bahusvel/HAPi-Cluster/hardware/chassis/renders/Early Laser Blade.JPG

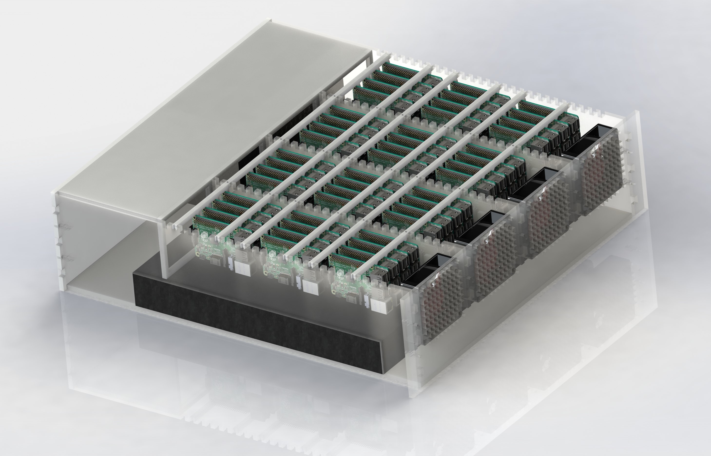
hardware/chassis/renders/Early Laser Blade.JPG
