bahusvel/HAPi-Cluster/hardware/chassis/renders/Later LaserBlade.JPG

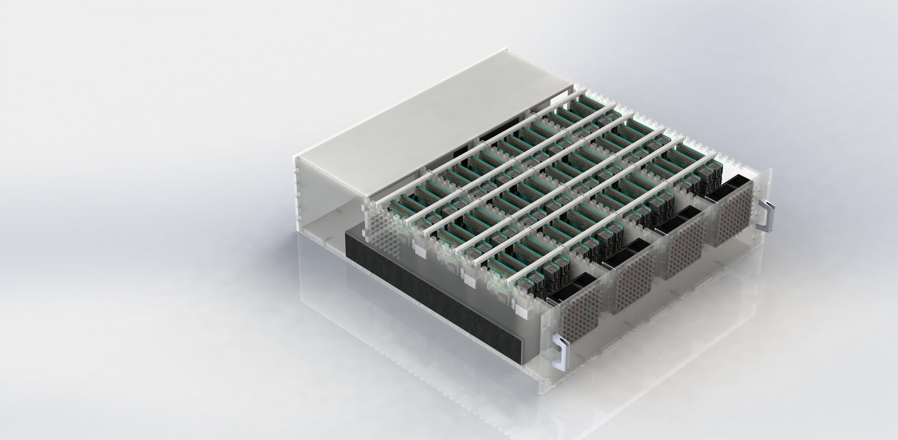
hardware/chassis/renders/Later LaserBlade.JPG
