bahusvel/HAPi-Cluster/README.md

# ClusterPipe
Flow processing scheduler daemon for real time parallel stream processing
