bahusvel/HAPi-Cluster/hardware/chassis/renders/In Rack Render.JPG

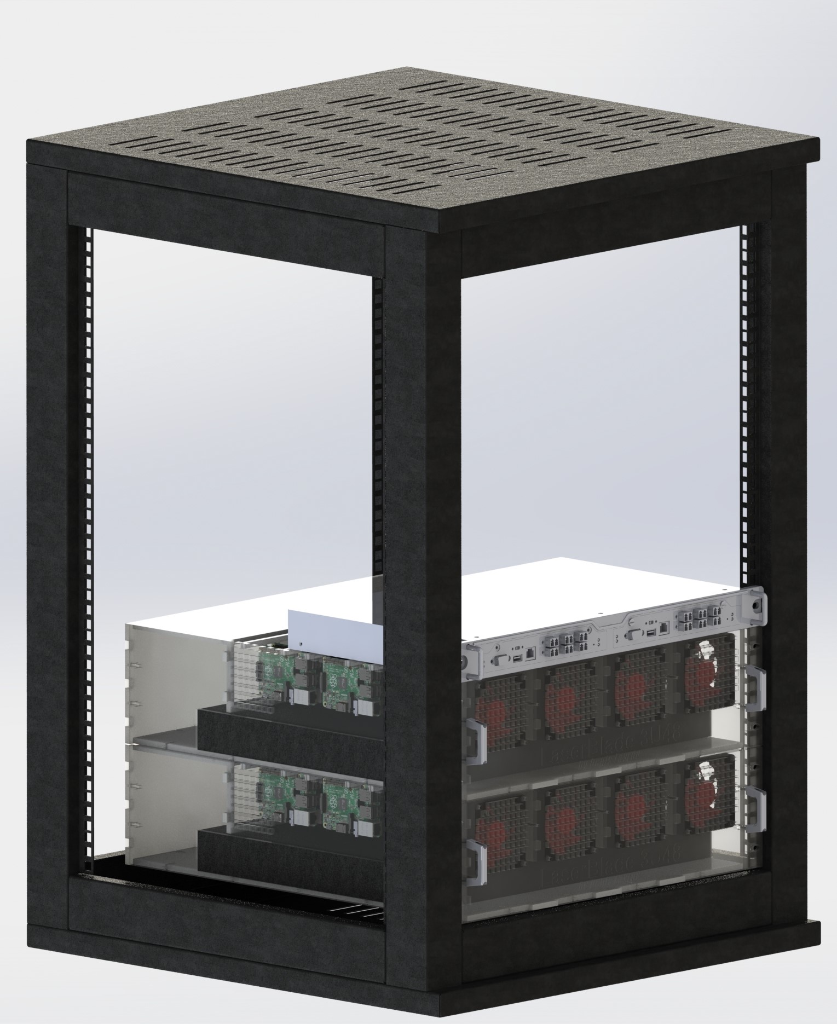
hardware/chassis/renders/In Rack Render.JPG
