bahusvel/HAPi-Cluster/hardware/chassis/sketch/Face.png

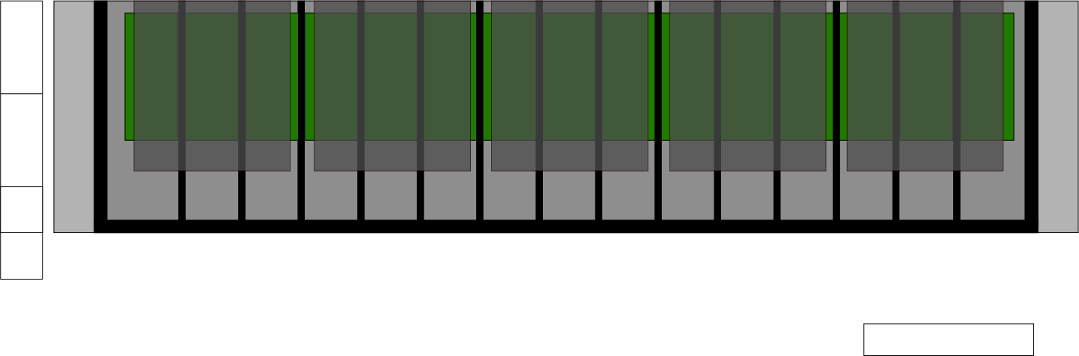
hardware/chassis/sketch/Face.png
