bahusvel/HAPi-Cluster/hardware/chassis/sketch/Top.png

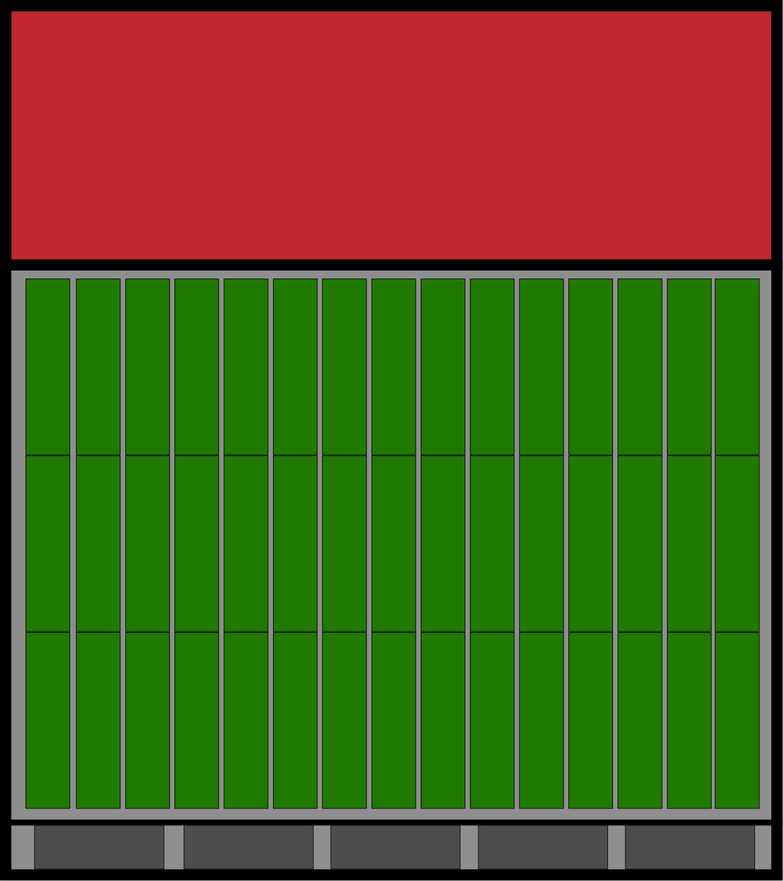
hardware/chassis/sketch/Top.png
