bahusvel/HAPi-Cluster/docs/Stage2.xlsx

Parts |  |  |  |  |  |  | USD->NZD:
Item | Link | Quantity | Cost USD | Cost NZD | Subtotal | Note | 1.39
N Channel Mosfet | http://nz.element14.com/fairchild-semiconductor/fdc6305n/mosfet-dual-nn-supersot-6/dp/9844805 | 60 |  | 0.779 | 46.74
Micro USB Vertical | http://nz.element14.com/global-connector-technology/usb3150-30-130-a/micro-usb-2-0-type-b-plug-th/dp/2537024 | 100 |  | 1.54 | 154
Acrylic 6mm | http://www.anythingacrylic.co.nz/flat-sheets/ | 6 |  | 50.78 | 304.68 | Cut to 900x600
Acryllic 4.5mm | http://www.anythingacrylic.co.nz/flat-sheets/ | 4 |  | 37.8 | 151.2 | Cut to 900x600
Local 10G SFP+ | https://www.pbtech.co.nz/product/NWXMLX1070/Mellanox-optical-module-ETH-10GbE-10Gbs-SFP-LC-LC | 4 |  | 205.85 | 823.4
LC/LC Multimode Patch | https://www.pbtech.co.nz/product/CABDNX7241/Dynamix-FL-LCLCOM4-1-1M-50u-LCLC-OM4-Fibre-Lead-Du | 4 |  | 21 | 84
M3 Fasteners | https://www.aliexpress.com/item/50pcs-Lot-Metric-M3-4-5-6-8-10-12-14-16-50mm-304-Stainless-Steel/32656651207.html | 4 | 3.6 | 5.004 | 20.016 | Choose 3x18
M3 Nuts | https://www.aliexpress.com/item/500PCS-M3-nut-M3-the-pillars-supporting-nut-nut-M3-screw/32618811604.html | 1 | 5.2 | 7.228 | 7.228
M4 Fasteners | https://www.aliexpress.com/item/50-pc-lot-M2-M2-5-M3-M4-L-4-50mm-DIN7991-Stainless-Steel-A2/32771971461.html | 2 | 5.7 | 7.923 | 15.846 | Choose M4 length 30mm
M4 Nuts | https://www.aliexpress.com/item/100pcs-M4-Nuts-A2-Stainless-Steel-Hex-Nuts-To-Fit-Our-Bolts-and-Screws/32668797352.html | 1 | 2.29 | 3.1831 | 3.1831
Multimode LC/LC Coupler | http://www.computerstore.co.nz/cables-connect/network-fibre-enclosures-cables-accessories/fibre-couplers/dynamix-fibre-lc-lc-quad-multi-mode-joiner | 2 |  | 10.66 | 21.32
Shift Registers | http://nz.element14.com/nxp/74hc595d/ic-74hc-cmos-smd-74hc595-soic16/dp/1201269 | 30 |  | 0.735 | 22.05
SMD LED | http://nz.element14.com/kingbright/kptr-3216seck/led-orange-1206-smd/dp/2099254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 | 100 |  | 0.241 | 24.1
SMT Resistor | http://nz.element14.com/vishay/crcw0402150rfkedhp/res-thick-film-150r-1-0-125w-0402/dp/1738839 | 100 |  | 0.033 | 3.3
PDU PCB | https://www.seeedstudio.com/fusion_pcb.html | 30 |  |  | 42.31 | Design provided by DENIS
Dell R230 3.5” Caddies | http://www.ebay.com/itm/3-5-SAS-SATA-Hard-Drive-Tray-Caddy-For-Dell-PowerEdge-Power-Edge-R230-R530-/361772477992 | 9 |  | 12.54 | 112.86 | Includes extra caddies for servers in the lab
Ribbon Cable | https://www.aliexpress.com/item/5m-lot-1-27mm-Pitch-20WAY-20P-Flat-Color-Rainbow-Ribbon-Cable-wire/1651786437.html | 2 | 6.99 | 9.7161 | 19.4322
12AWG Wire | https://www.jaycar.co.nz/1-0mm-enamel-copper-wire-spool/p/WW4022 | 2 |  | 13.9 | 27.8
C19 to AU power cord | https://www.pbtech.co.nz/product/CABPSU0107/Dynamix-C-PC15A-2M-Power-Cord---15-Amp-Rated-3-pin | 1 |  | 20.64 | 20.64
C13 to C14 cables | https://www.pbtech.co.nz/product/ITPCAP201/Dynamix-05M-SAA-Approved-Power-Cord-IEC-Male-to-Fe | 5 |  | 2.98 | 14.9
C14 to AU Socket | https://www.jaycar.com.au/iec-c14-male-to-3pin-mains-socket-150mm/p/PS4100 | 5 |  | 8.75 | 43.75
C14 Socket | http://nz.element14.com/multicomp/jr-101-1-frsg-02/inlet-iec-dpst-with-fuse-holder/dp/1516058 | 5 |  | 9.14 | 45.7
Microcontroller | https://www.aliexpress.com/item/Micro-ATmega32U4-5V-16MHz-Pins-soldered-Compatible-with-Arduino-Micro-and-Leonardo/32676998690.html | 3 | 4.8 | 6.672 | 20.016
12V Boost Converter | https://www.aliexpress.com/item/8W-USB-Input-DC-DC-5V-to-12V-Converter-Step-Up-Module-Power-Supply-Boost-Module/32756881160.html | 3 | 0.8 | 1.112 | 3.336
Crimping Tool | https://www.jaycar.com.au/5-way-crimping-tool/p/TH1828 | 1 |  | 8.95 | 8.95
Right Angle 40 Pin Female Header | https://www.aliexpress.com/item/Free-Shipping-one-lot-10pcs-2x20-Pin-2-54mm-Double-Row-Right-Angle-Female-Pin-Header/1680722686.html | 10 | 5.77 | 8.0203 | 80.203
Female 40 Pin Header | https://www.aliexpress.com/item/100pcs-lot-2-54mm-Double-Row-Female-12P-Straight-Header-Pitch-Socket-Strip-2X20-Pin/32454935478.html | 1 | 11.6 | 16.124 | 16.124
Parallella Desktop Board | http://www.digikey.co.nz/product-detail/en/adapteva-inc/P1600-DK02/1554-1000-ND/5018661 | 1 |  | 246.37 | 246.37
Parallella Server Board | http://www.digikey.co.nz/product-detail/en/adapteva-inc/P1601-DK02/1554-1001-ND/5018662 | 4 |  | 196.77 | 787.08
80mm Fan Filters | https://www.jaycar.com.au/80mm-plastic-fan-guard-filter-kit/p/YX2552 | 8 |  | 6.25 | 50
RJ45 Vertical Male PCB Connector | http://nz.element14.com/metz-connect/ajp92a8813/connector-rj45-plug-1port-8p8c/dp/2442534 | 100 |  | 2.53 | 253
Acrylic Cement | http://www.anythingacrylic.co.nz/anything-acrylic/accessories/acrylic-cement/ | 2 |  | 21 | 42 | Choose 5oz
Fork Crimps | https://www.aliexpress.com/item/1000Pcs-Electrical-Wire-Connector-Insulated-Crimp-Terminals-Kit-Spade-Assorted-Set-Fork-Ring-Assorted-Set-With/32751240130.html | 2 | 15.99 | 22.2261 | 44.4522
Heatshrink | https://www.aliexpress.com/item/280PCS-1-8-H-Assorted-Halogen-free-2-1-Polyolefin-Insulation-HeatShrink-Tubing-Tube-Kit-Shrinkable/32675699214.html | 2 | 6.11 | 8.4929 | 16.9858
 |  |  |  | Total: | 3473.5343
