bahusvel/HAPi-Cluster/hardware/chassis/components/rpi/raspberry_pi_B+_(HDMI_socket).SLDASM

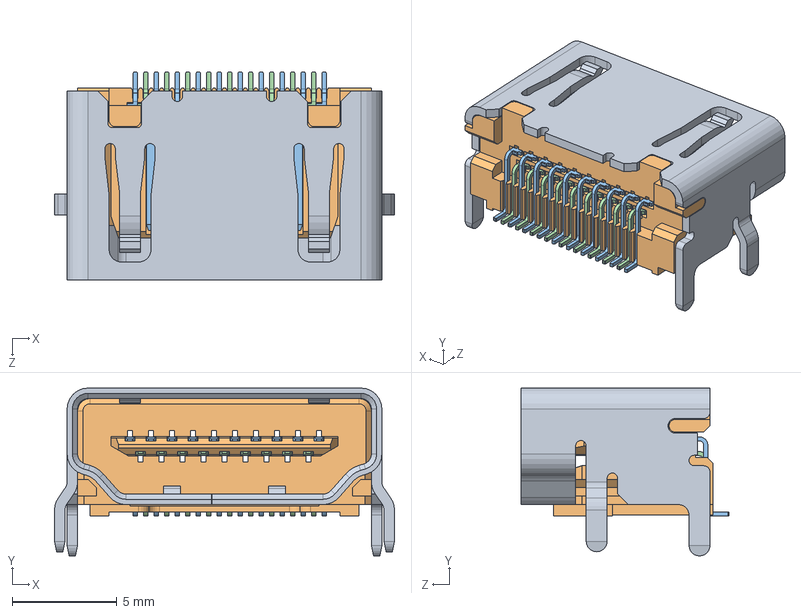
[picture p6: CAD file, 2017-01-25]
hardware/chassis/components/rpi/raspberry_pi_B+_(HDMI_socket).SLDASM
16.2 x 8.00 x 9.90 mm
raspberry_pi__HDMI_socket_cover
raspberry_pi__HDMI_socket_inside
raspberry_pi__HDMI_socket_large_pin x 10
raspberry_pi__HDMI_socket_small_pin x 9
