bahusvel/HAPi-Cluster/hardware/chassis/components/rpi/raspberry_pi_B+_(micro_USB).SLDASM

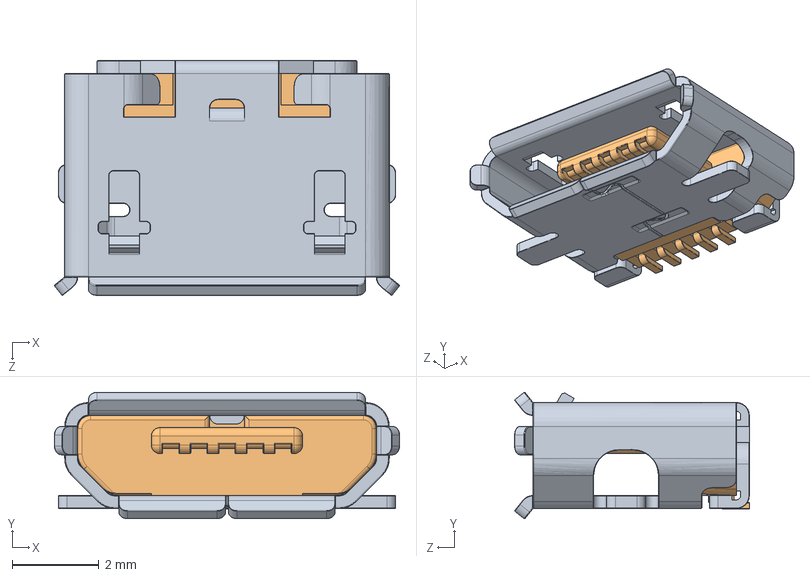
[picture p7: CAD file, 2017-01-25]
hardware/chassis/components/rpi/raspberry_pi_B+_(micro_USB).SLDASM
7.97 x 2.92 x 5.43 mm
raspberry_pi_B+_(micro_USB_cover)
raspberry_pi_B+_(micro_USB_contacts)
