bahusvel/HAPi-Cluster/hardware/chassis/components/server/User Library-fod-assy_asm.sldasm

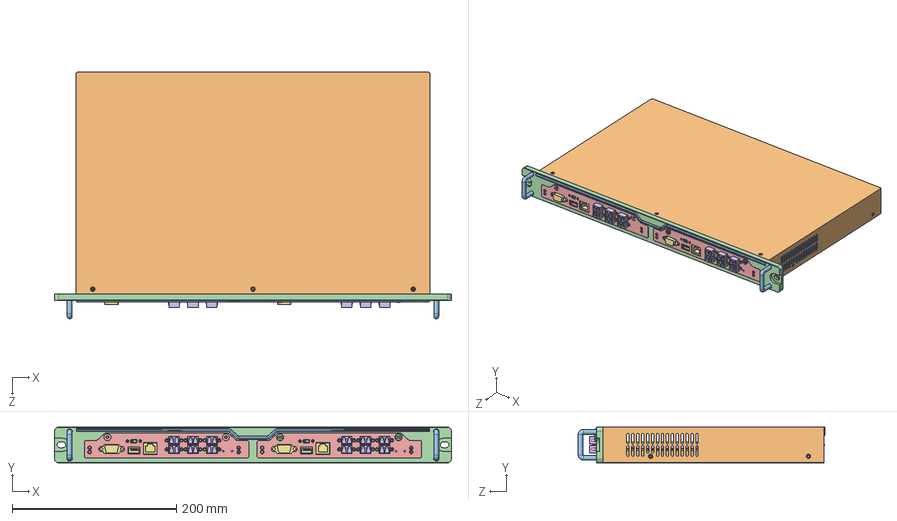
[picture p8: CAD file, 2017-02-03]
hardware/chassis/components/server/User Library-fod-assy_asm.sldasm
483.0 x 43.5 x 300.1 mm
User Library-fod-assy_asm_FOD-BASE
User Library-fod-assy_asm_FOD-TOP-COVER
User Library-fod-assy_asm_PRT0002 x 2
User Library-fod-assy_asm_FOD-FRONT-PANEL
User Library-fod-assy_asm_FOD-IO-PANEL x 2
User Library-fod-assy_asm_CONN-LC-TYPE-SCREW x 12
User Library-fod-assy_asm_FOD-MAIN-BD x 2
User Library-fod-assy_asm_SLIDE-SWITCH x 4
User Library-fod-assy_asm_FOD-BD-COVER x 2
User Library-fod-assy_asm_FOD-PCB-GUIDE x 4
User Library-fod-assy_asm_FOD-DESIGN-BAR
User Library-fod-assy_asm_FOD-CAP-SCREW x 2
User Library-fod-assy_asm_FOD-FRONT-BRKT
User Library-fod-assy_asm_FOD-SIDE-BRKT x 2
User Library-fod-assy_asm_FOD-BP-BD-ST
