bahusvel/HAPi-Cluster/hardware/chassis/rail_subasm.SLDASM

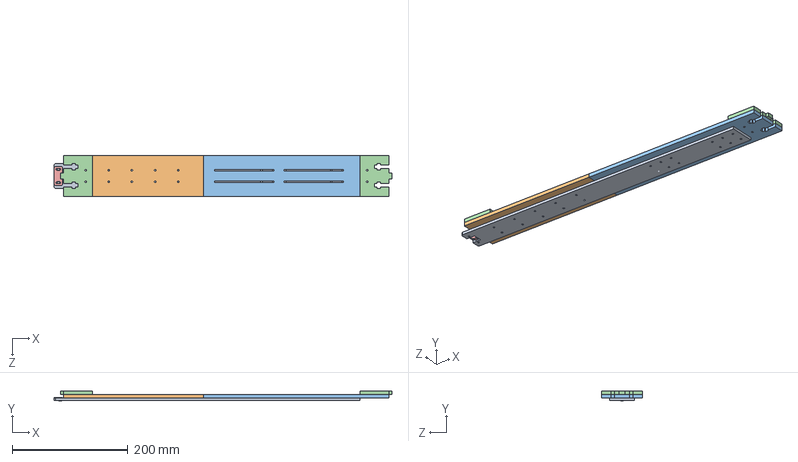
[picture p9: CAD file, 2017-02-11]
hardware/chassis/rail_subasm.SLDASM
583.5 x 17.5 x 70.0 mm
main_rail_4mm
rail_support_6mm
sliding_rail_6mm
railwidth_6mm x 2
rail_latch_3d
