bahusvel/HAPi-Cluster/hardware/chassis/lid_subasm.SLDASM

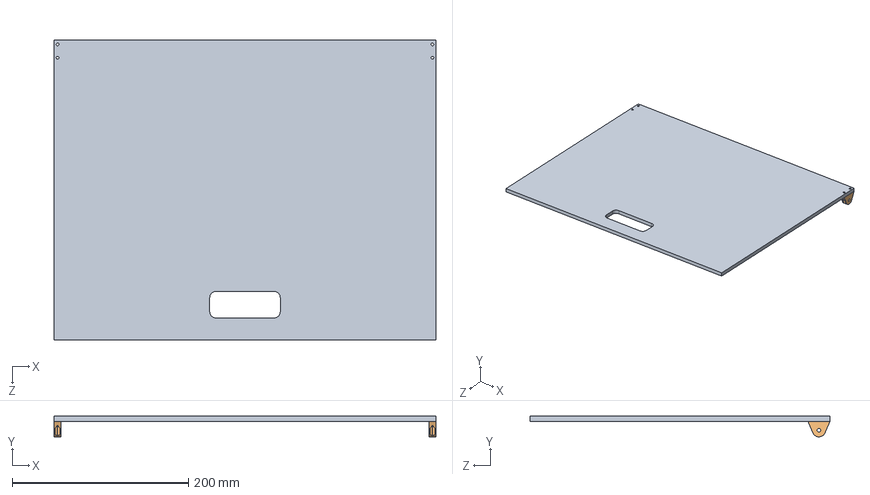
[picture p11: CAD file, 2017-02-11]
hardware/chassis/lid_subasm.SLDASM
433.0 x 23.5 x 340.0 mm
unit_lid_6mm
lid_hinge_3d x 2
