bahusvel/HAPi-Cluster/hardware/chassis/main_rail_4mm.SLDPRT

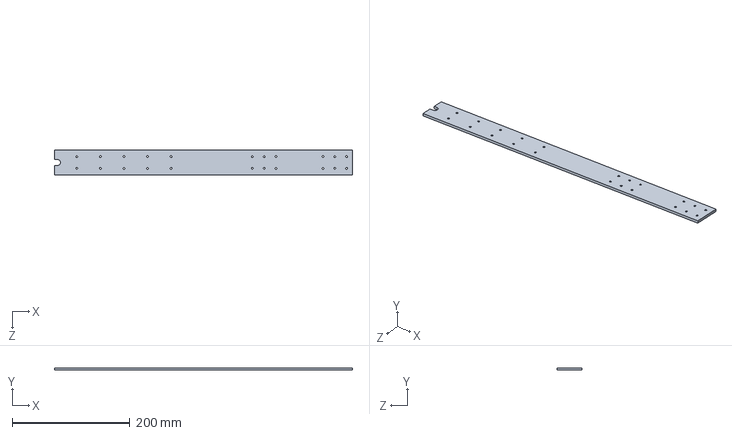
[picture p12: CAD file, 2017-02-11]
hardware/chassis/main_rail_4mm.SLDPRT
506.0 x 4.00 x 43.0 mm
