bahusvel/HAPi-Cluster/hardware/chassis/components/rpi/raspberry_pi_B+_(USB_x2).SLDASM

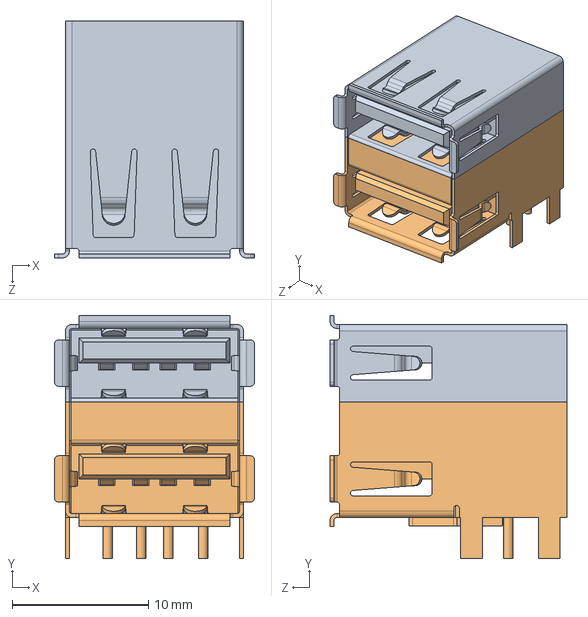
[picture p13: CAD file, 2017-01-25]
hardware/chassis/components/rpi/raspberry_pi_B+_(USB_x2).SLDASM
14.7 x 17.9 x 17.4 mm
raspberry_pi_B+_(USB_x2_part1)
raspberry_pi_B+_(USB_x2_part2)
