bahusvel/HAPi-Cluster/hardware/chassis/components/rpi/raspberry_pi_B+_(microsd).SLDASM

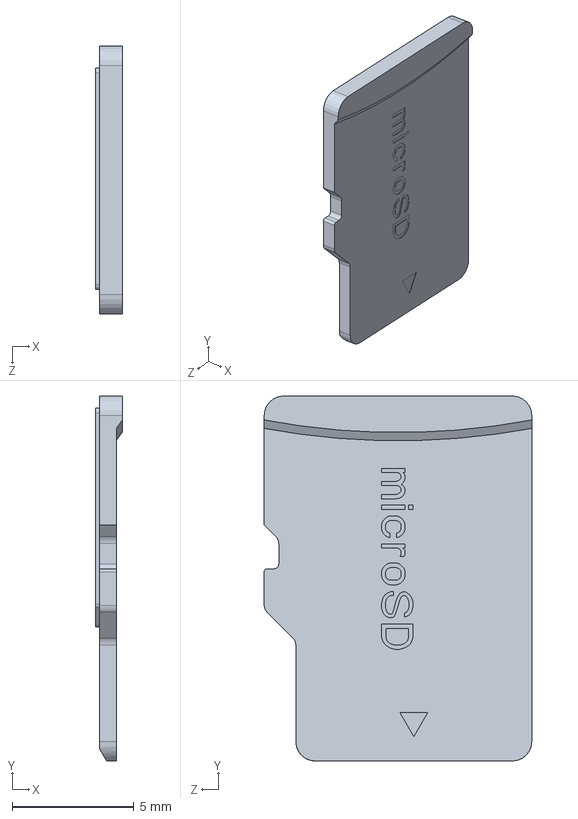
[picture p14: CAD file, 2017-01-17]
hardware/chassis/components/rpi/raspberry_pi_B+_(microsd).SLDASM
1.10 x 15.0 x 11.0 mm
