bahusvel/HAPi-Cluster/hardware/chassis/components/rpi/raspberry_pi_B+_(microsd_slot).SLDASM

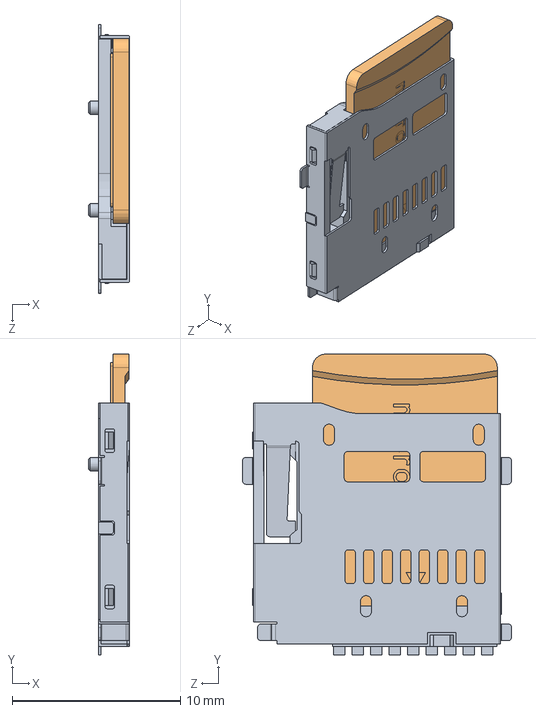
[picture p15: CAD file, 2017-01-17]
hardware/chassis/components/rpi/raspberry_pi_B+_(microsd_slot).SLDASM
2.44 x 17.9 x 16.0 mm
raspberry_pi_B+_(slot)
raspberry_pi_B+_(microsd)
