bahusvel/HAPi-Cluster/hardware/chassis/components/rpi/raspberry_pi_B+_(slot).SLDASM

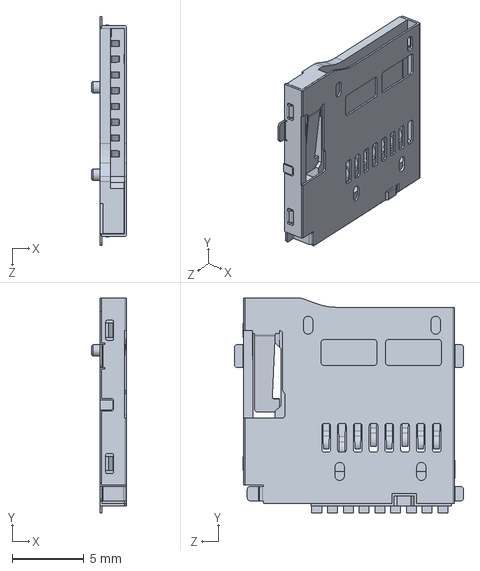
[picture p16: CAD file, 2017-01-17]
hardware/chassis/components/rpi/raspberry_pi_B+_(slot).SLDASM
2.44 x 15.0 x 16.0 mm
