bahusvel/HAPi-Cluster/hardware/chassis/components/power supply.SLDPRT

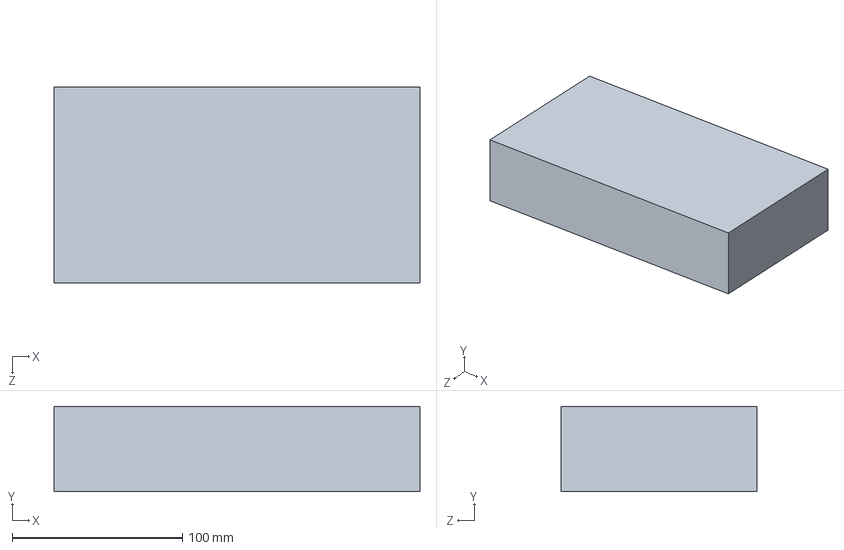
[picture p17: CAD file, 2017-02-11]
hardware/chassis/components/power supply.SLDPRT
215.0 x 50.0 x 115.0 mm
