bahusvel/HAPi-Cluster/hardware/chassis/components/rpi/raspberry_pi_B+_(audio_video2).SLDPRT

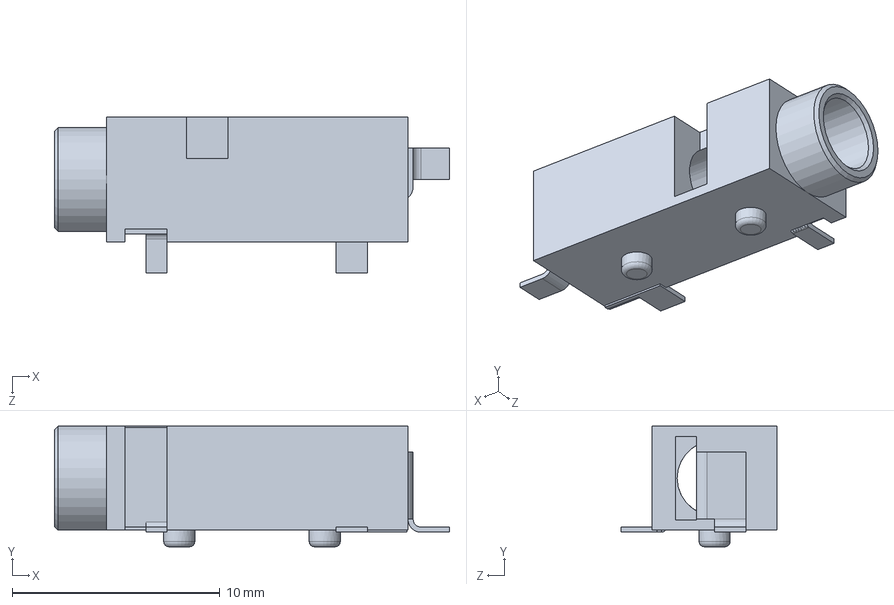
[picture p18: CAD file, 2017-01-25]
hardware/chassis/components/rpi/raspberry_pi_B+_(audio_video2).SLDPRT
19.0 x 5.80 x 7.50 mm
