bahusvel/HAPi-Cluster/hardware/chassis/components/shelf/TCH-506-9031900.SLDPRT

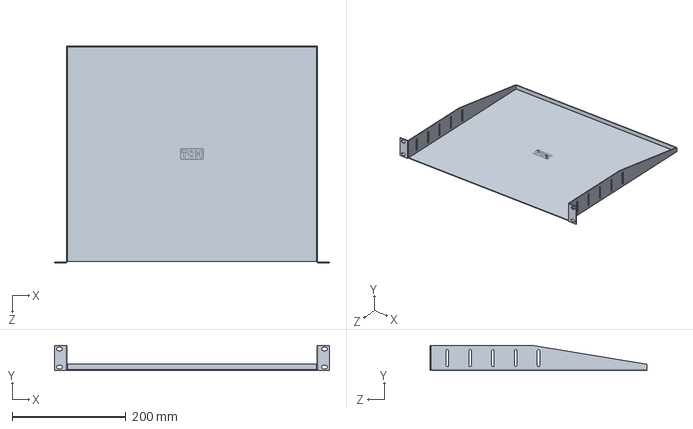
[picture p19: CAD file, 2017-02-03]
hardware/chassis/components/shelf/TCH-506-9031900.SLDPRT
482.6 x 44.1 x 380.0 mm
