bahusvel/HAPi-Cluster/hardware/chassis/bottom_plate_6mm.SLDPRT

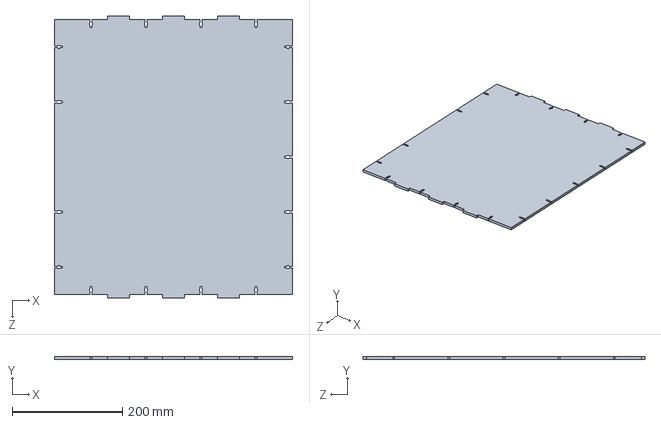
[picture p20: CAD file, 2017-03-06]
hardware/chassis/bottom_plate_6mm.SLDPRT
433.0 x 6.00 x 512.0 mm
