bahusvel/HAPi-Cluster/hardware/chassis/components/pdu_board.SLDPRT

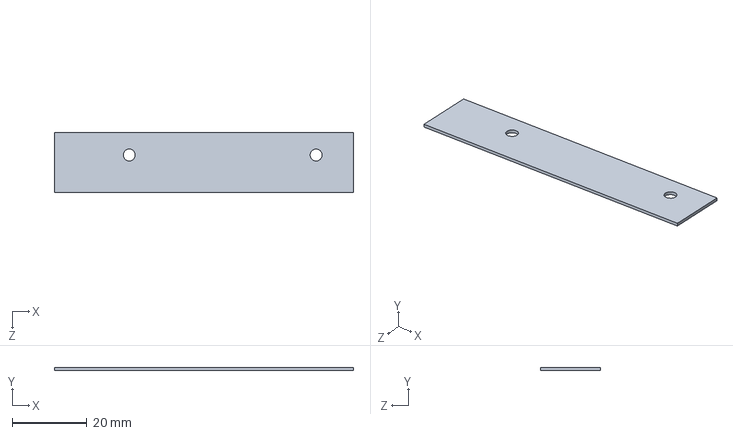
[picture p21: CAD file, 2017-01-30]
hardware/chassis/components/pdu_board.SLDPRT
80.0 x 0.8 x 16.0 mm
