bahusvel/HAPi-Cluster/hardware/chassis/components/fan/sunon_fan_red.stp

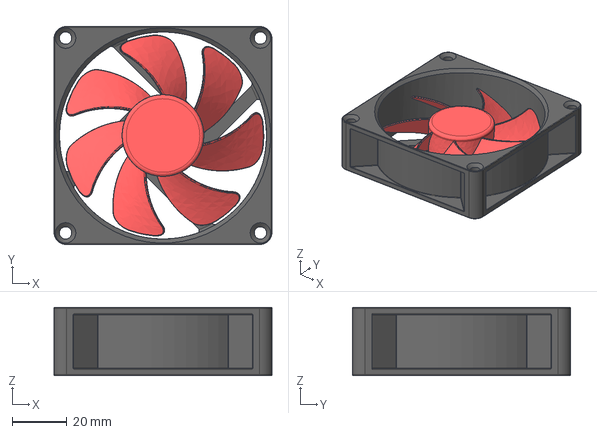
[picture p22: CAD file, 2017-01-17]
hardware/chassis/components/fan/sunon_fan_red.stp
80.0 x 80.0 x 25.0 mm
