bahusvel/HAPi-Cluster/hardware/chassis/components/rpi/raspberry_pi__HDMI_socket_inside.SLDPRT

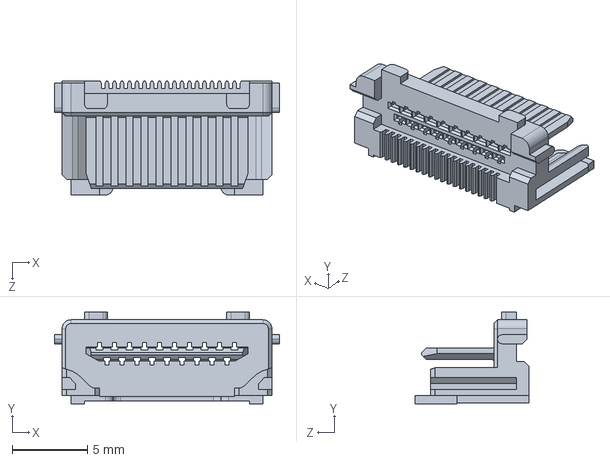
[picture p23: CAD file, 2017-01-25]
hardware/chassis/components/rpi/raspberry_pi__HDMI_socket_inside.SLDPRT
15.0 x 6.10 x 7.60 mm
