bahusvel/HAPi-Cluster/hardware/chassis/components/switch.SLDPRT

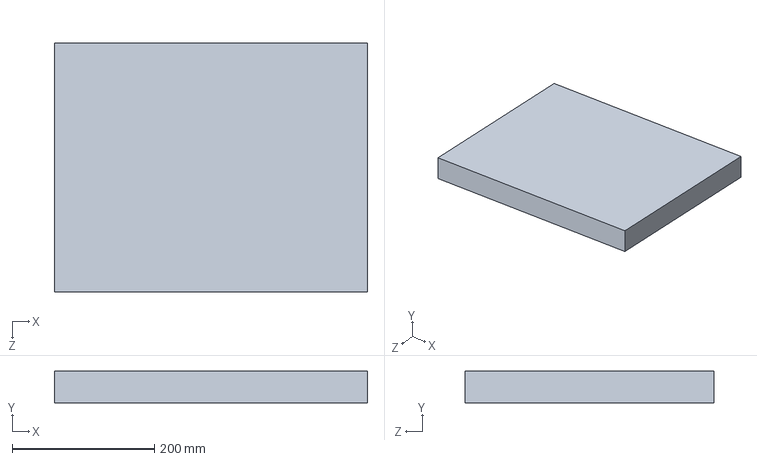
[picture p24: CAD file, 2017-01-25]
hardware/chassis/components/switch.SLDPRT
440.0 x 44.5 x 350.0 mm
