bahusvel/HAPi-Cluster/hardware/chassis/face_plate_6mm.SLDPRT

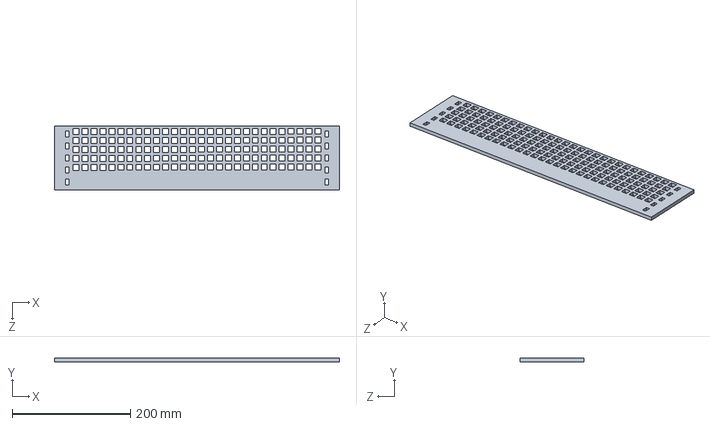
[picture p25: CAD file, 2017-03-06]
hardware/chassis/face_plate_6mm.SLDPRT
482.6 x 6.00 x 109.1 mm
