bahusvel/HAPi-Cluster/hardware/chassis/back_panel_6mm.SLDPRT

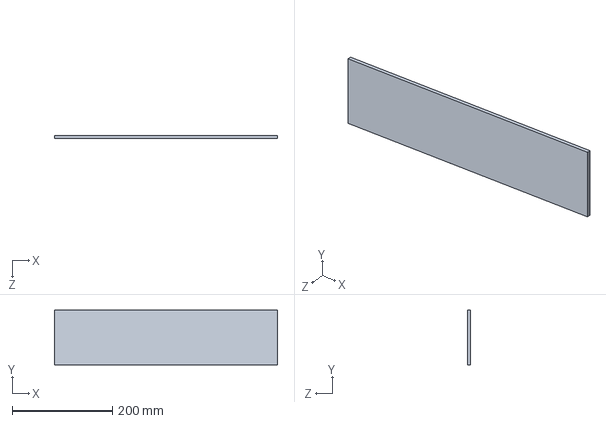
[picture p26: CAD file, 2017-03-06]
hardware/chassis/back_panel_6mm.SLDPRT
445.0 x 109.1 x 6.00 mm
