bahusvel/HAPi-Cluster/hardware/chassis/components/rack_backup/19inch Rack 16U.stp

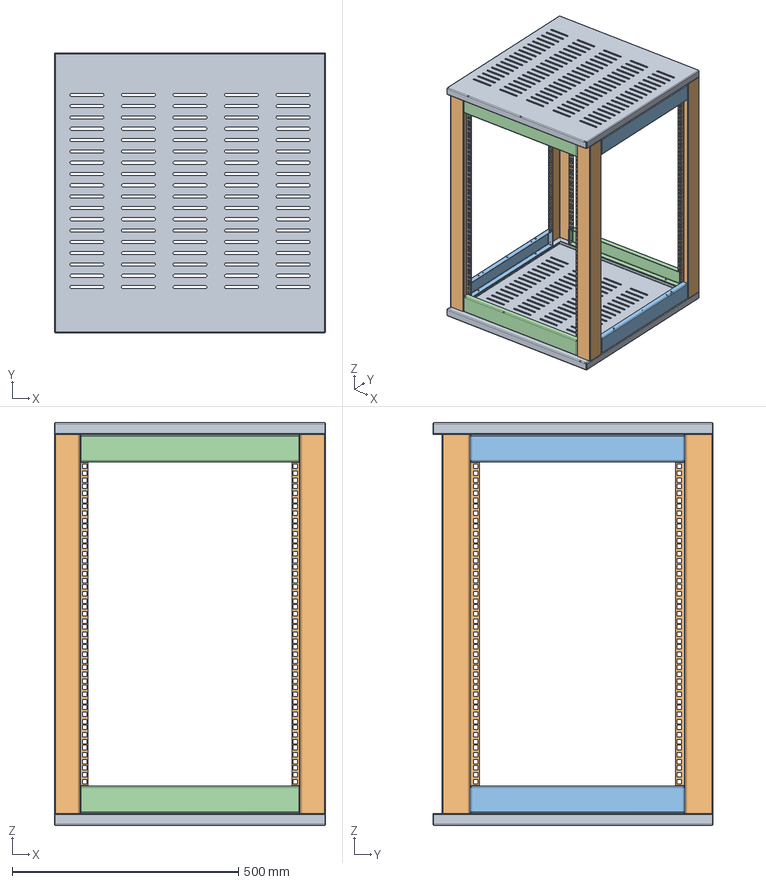
[picture p27: CAD file, 2017-01-17]
hardware/chassis/components/rack_backup/19inch Rack 16U.stp
600.0 x 620.0 x 891.0 mm
19inch Rack Top x 2
19inch Rack Corner Section x 16U x 4
19inch Rack In Fill section Side x 4
19inch Rack In Fill section Front-Rear x 4
