bahusvel/HAPi-Cluster/hardware/chassis/components/rpi/raspberry_pi_B+_(CI_Board).SLDPRT

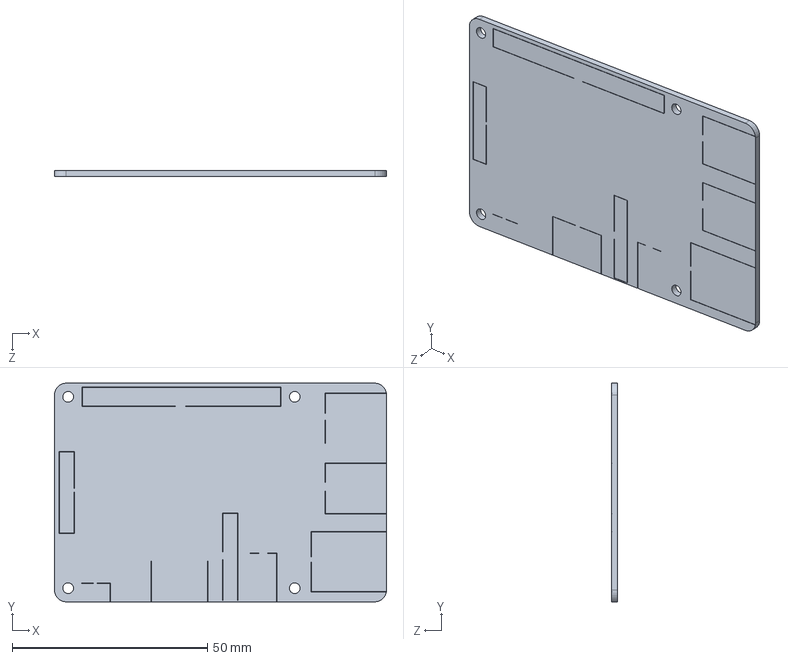
[picture p28: CAD file, 2017-01-25]
hardware/chassis/components/rpi/raspberry_pi_B+_(CI_Board).SLDPRT
85.0 x 56.0 x 1.60 mm
