bahusvel/HAPi-Cluster/hardware/chassis/components/rpi/raspberry_pi_B+_(microsd_slot2).SLDPRT

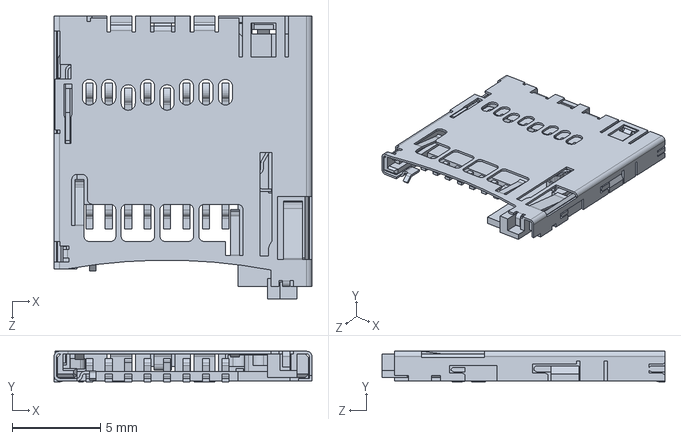
[picture p29: CAD file, 2017-01-25]
hardware/chassis/components/rpi/raspberry_pi_B+_(microsd_slot2).SLDPRT
14.6 x 1.73 x 16.0 mm
