bahusvel/HAPi-Cluster/hardware/chassis/power_separator_6mm.SLDPRT

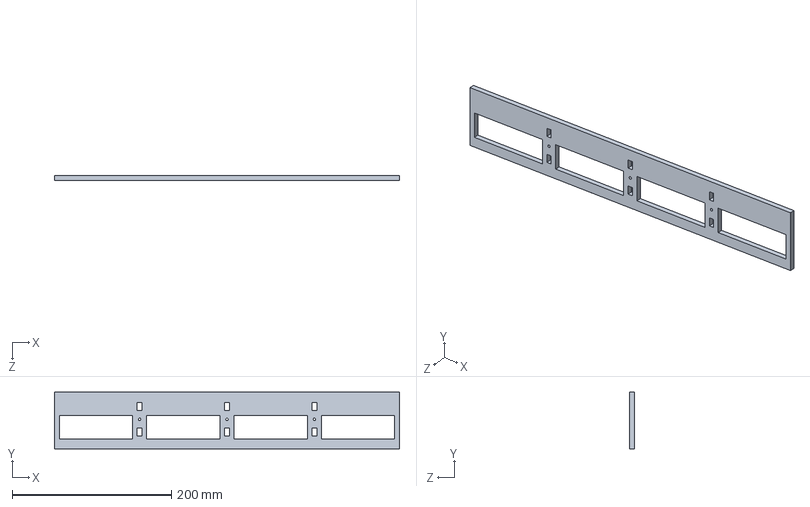
[picture p30: CAD file, 2017-03-06]
hardware/chassis/power_separator_6mm.SLDPRT
433.0 x 71.0 x 6.00 mm
