bahusvel/HAPi-Cluster/hardware/chassis/components/rpi/raspberry_pi_B+_(microsd2).SLDPRT

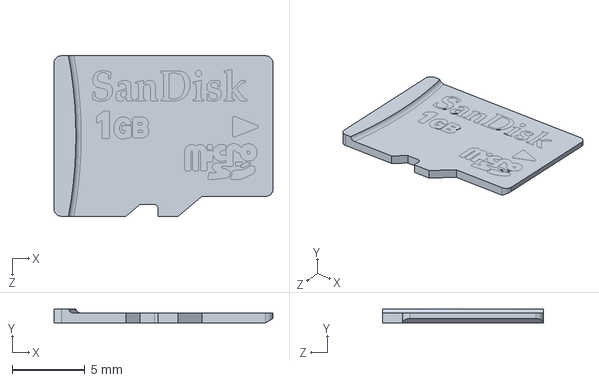
[picture p31: CAD file, 2017-01-25]
hardware/chassis/components/rpi/raspberry_pi_B+_(microsd2).SLDPRT
15.0 x 0.975 x 11.0 mm
