bahusvel/HAPi-Cluster/hardware/chassis/rib_6mm.SLDPRT

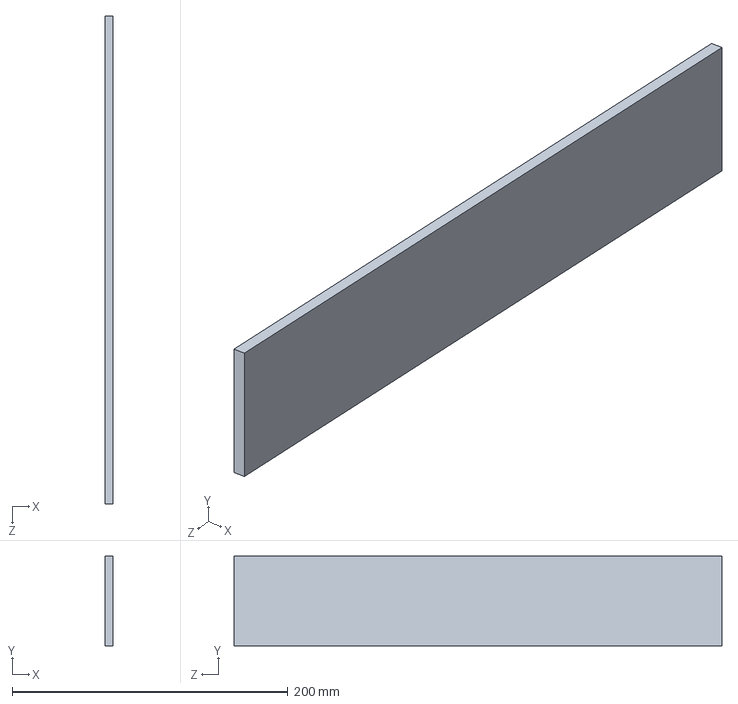
[picture p32: CAD file, 2017-02-11]
hardware/chassis/rib_6mm.SLDPRT
6.00 x 65.0 x 354.0 mm
