bahusvel/HAPi-Cluster/hardware/chassis/components/rpi/raspberry_pi_B+_(micro_USB_cover).SLDPRT

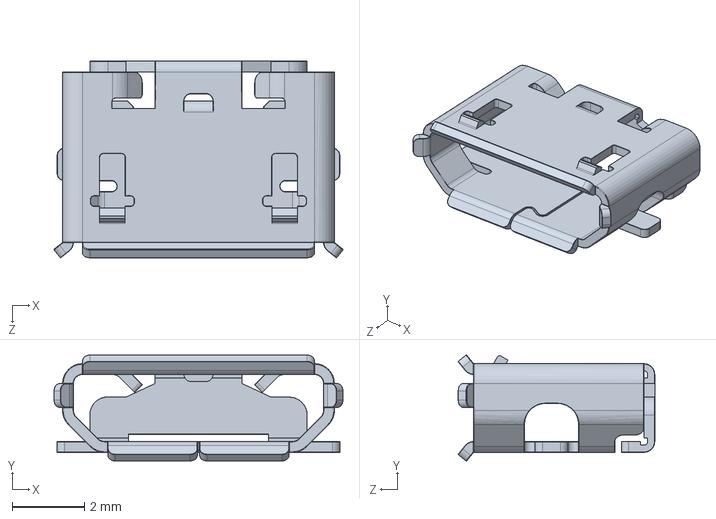
[picture p33: CAD file, 2017-01-25]
hardware/chassis/components/rpi/raspberry_pi_B+_(micro_USB_cover).SLDPRT
7.97 x 2.92 x 5.43 mm
