bahusvel/HAPi-Cluster/hardware/chassis/unit_lid_6mm.SLDPRT

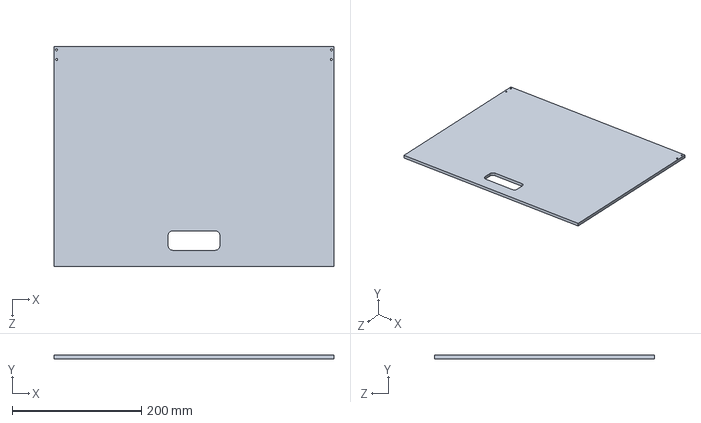
[picture p34: CAD file, 2017-02-11]
hardware/chassis/unit_lid_6mm.SLDPRT
433.0 x 6.00 x 340.0 mm
