bahusvel/HAPi-Cluster/hardware/chassis/power_lid_6mm.sldprt

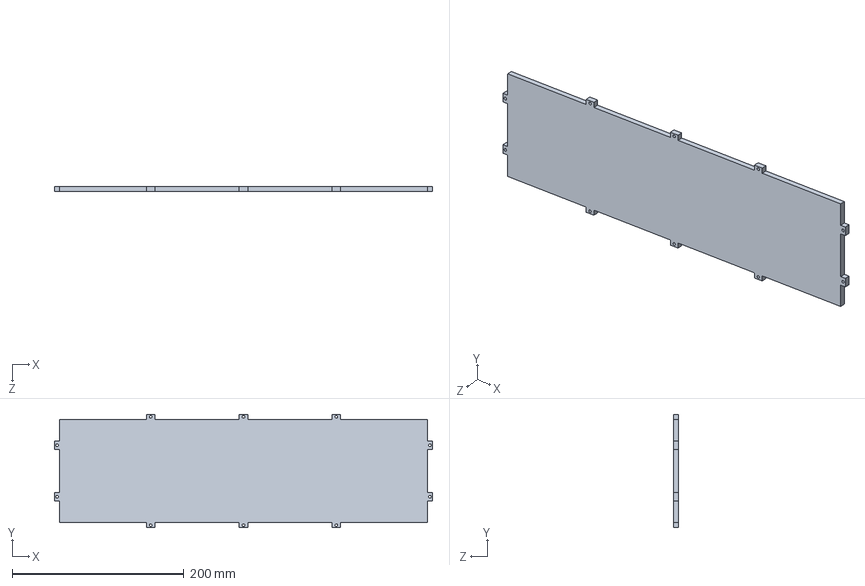
[picture p35: CAD file, 2017-02-11]
hardware/chassis/power_lid_6mm.sldprt
440.0 x 132.0 x 6.00 mm
