bahusvel/HAPi-Cluster/hardware/chassis/components/rpi/raspberry_pi__HDMI_socket_small_pin.SLDPRT

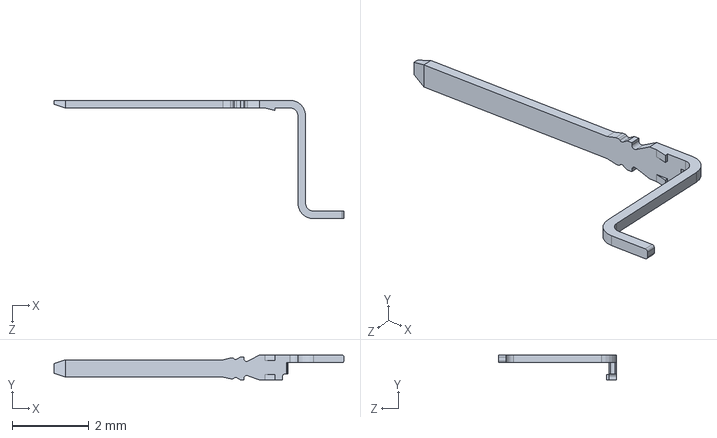
[picture p36: CAD file, 2017-01-25]
hardware/chassis/components/rpi/raspberry_pi__HDMI_socket_small_pin.SLDPRT
7.55 x 0.65 x 3.08 mm
