bahusvel/HAPi-Cluster/hardware/chassis/components/rpi/raspberry_pi_B+_(micro_USB_contacts).SLDPRT

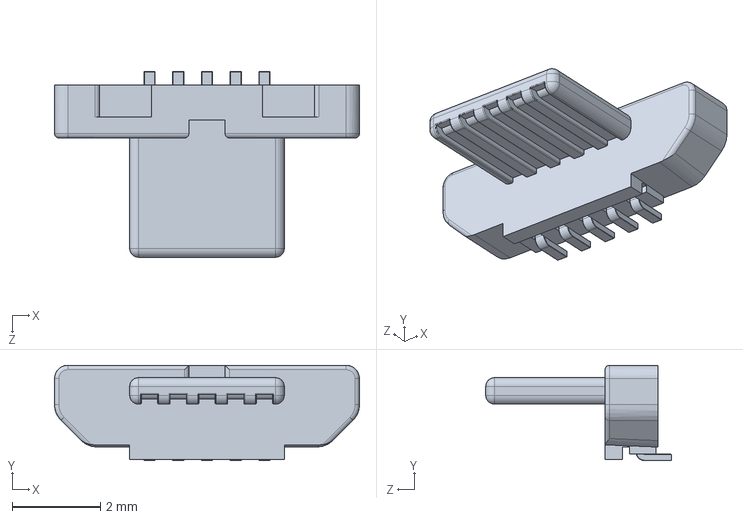
[picture p37: CAD file, 2017-01-25]
hardware/chassis/components/rpi/raspberry_pi_B+_(micro_USB_contacts).SLDPRT
6.90 x 2.16 x 4.20 mm
