bahusvel/HAPi-Cluster/hardware/chassis/side_plate_6mm.SLDPRT

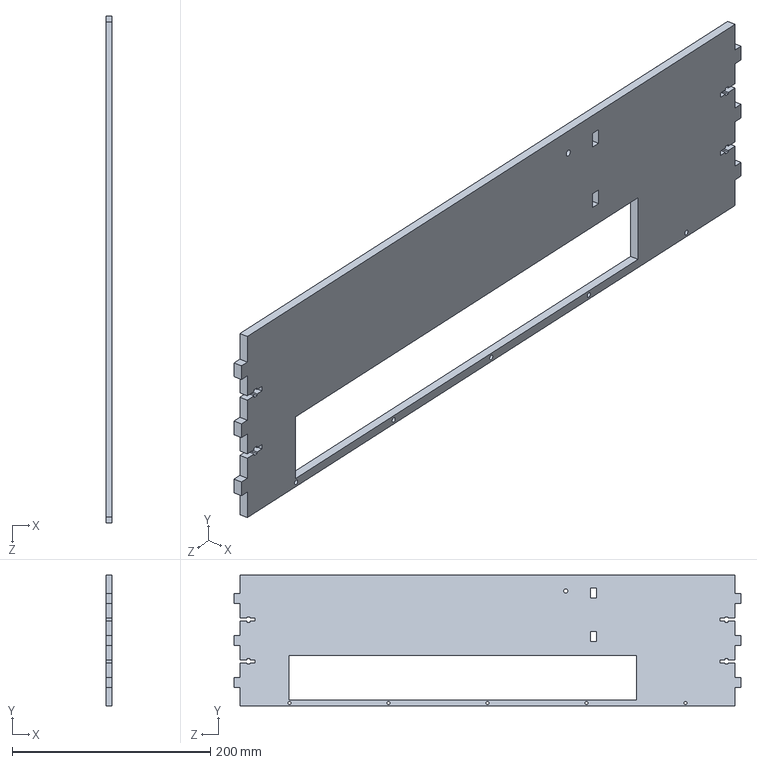
[picture p38: CAD file, 2017-02-11]
hardware/chassis/side_plate_6mm.SLDPRT
6.00 x 132.0 x 512.0 mm
