bahusvel/HAPi-Cluster/hardware/chassis/components/rpi/raspberry_pi_B+_(168_FBGA_12x12).SLDPRT

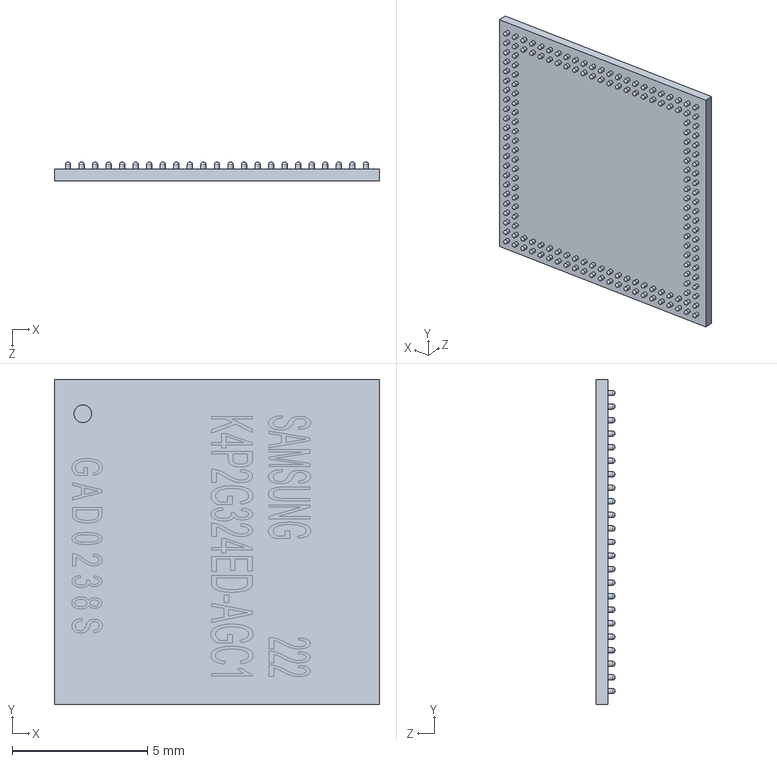
[picture p39: CAD file, 2017-01-25]
hardware/chassis/components/rpi/raspberry_pi_B+_(168_FBGA_12x12).SLDPRT
12.0 x 12.0 x 0.71 mm
