bahusvel/HAPi-Cluster/hardware/chassis/lower_rail_4mm.SLDPRT

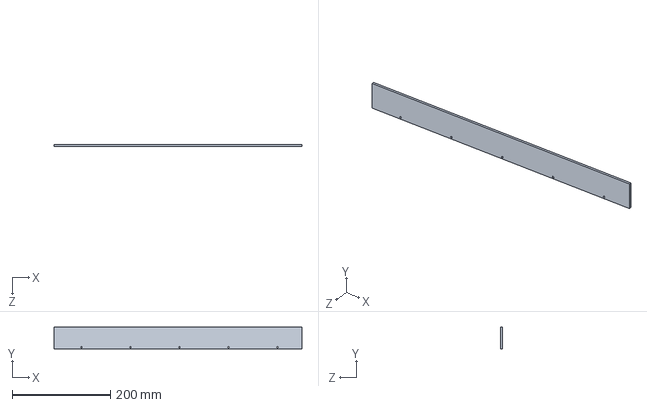
[picture p40: CAD file, 2017-02-11]
hardware/chassis/lower_rail_4mm.SLDPRT
506.0 x 44.0 x 4.00 mm
