bahusvel/HAPi-Cluster/hardware/chassis/components/rpi/raspberry_pi_B+_(USB_x2_part1).SLDPRT

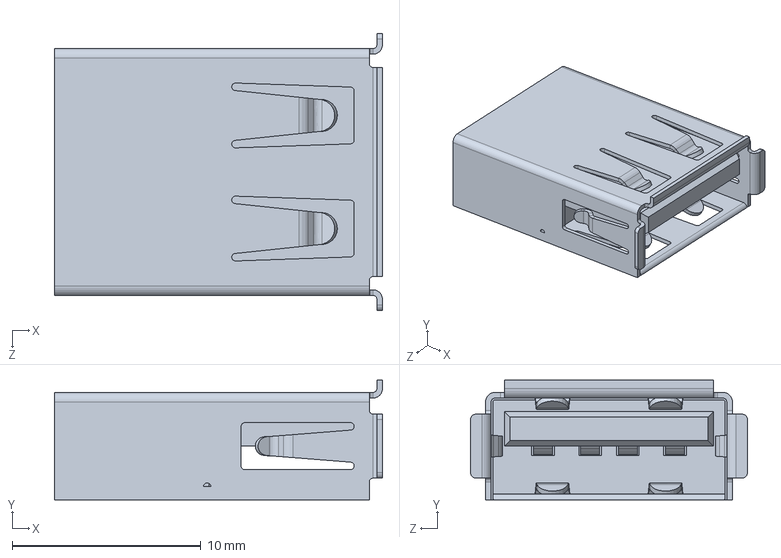
[picture p41: CAD file, 2017-01-25]
hardware/chassis/components/rpi/raspberry_pi_B+_(USB_x2_part1).SLDPRT
17.4 x 6.35 x 14.7 mm
