bahusvel/HAPi-Cluster/hardware/chassis/components/rpi/raspberry_pi__HDMI_socket_cover.SLDPRT

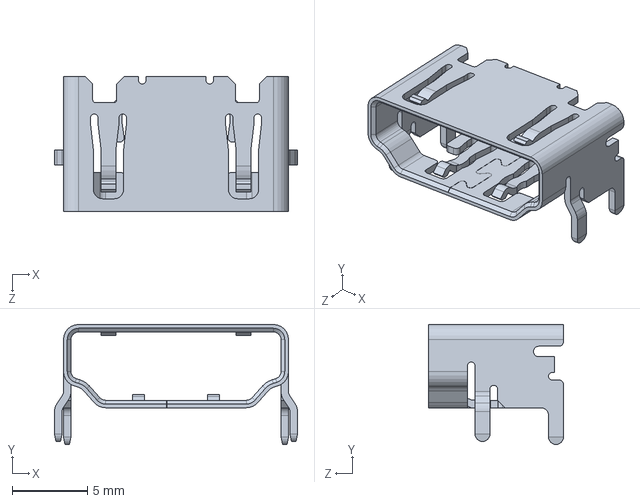
[picture p42: CAD file, 2017-01-25]
hardware/chassis/components/rpi/raspberry_pi__HDMI_socket_cover.SLDPRT
16.2 x 8.00 x 9.00 mm
