bahusvel/HAPi-Cluster/hardware/chassis/3u_handle_3D.SLDPRT

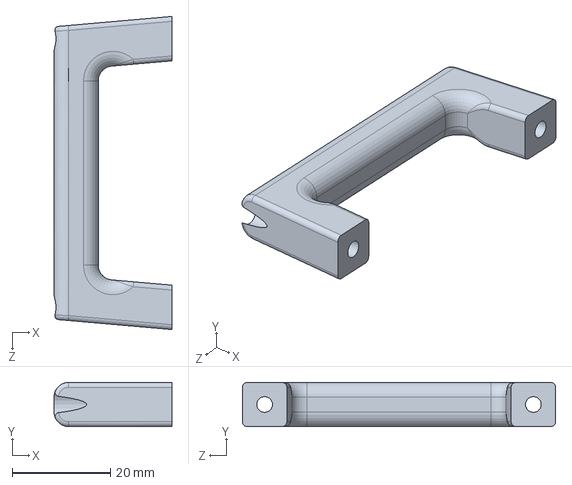
[picture p43: CAD file, 2017-02-11]
hardware/chassis/3u_handle_3D.SLDPRT
24.0 x 9.00 x 63.7 mm
