bahusvel/HAPi-Cluster/hardware/chassis/components/rpi/raspberry_pi__15_pin_FFC_Connector_locker.SLDPRT

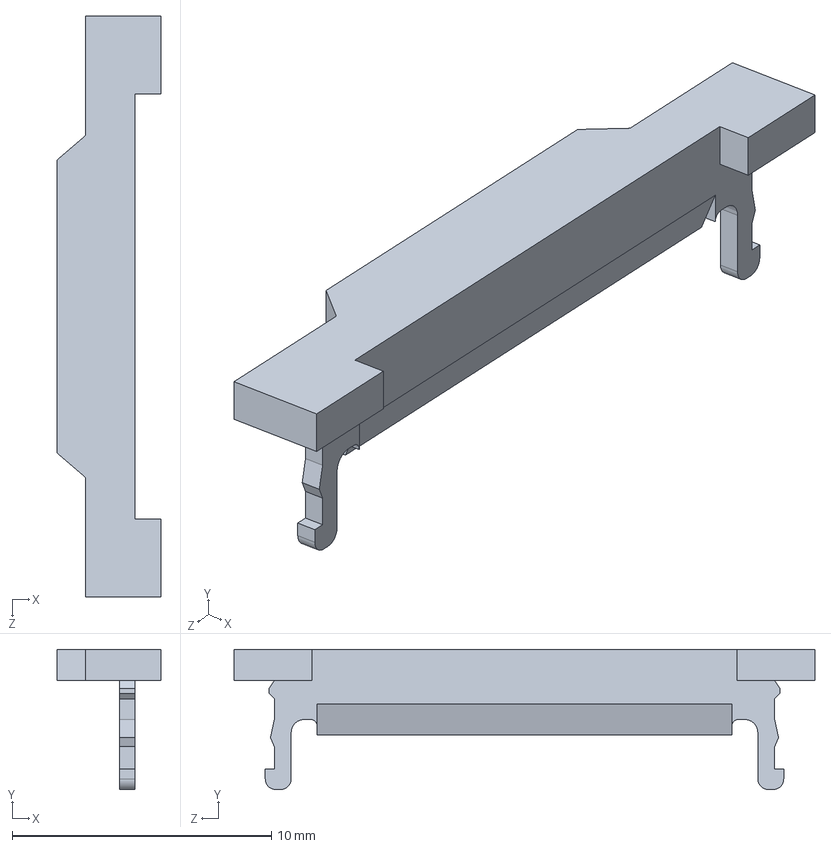
[picture p44: CAD file, 2017-01-25]
hardware/chassis/components/rpi/raspberry_pi__15_pin_FFC_Connector_locker.SLDPRT
4.00 x 5.40 x 22.4 mm
