bahusvel/HAPi-Cluster/hardware/chassis/components/rpi/raspberry_pi_B+_(USB_x2_part2).SLDPRT

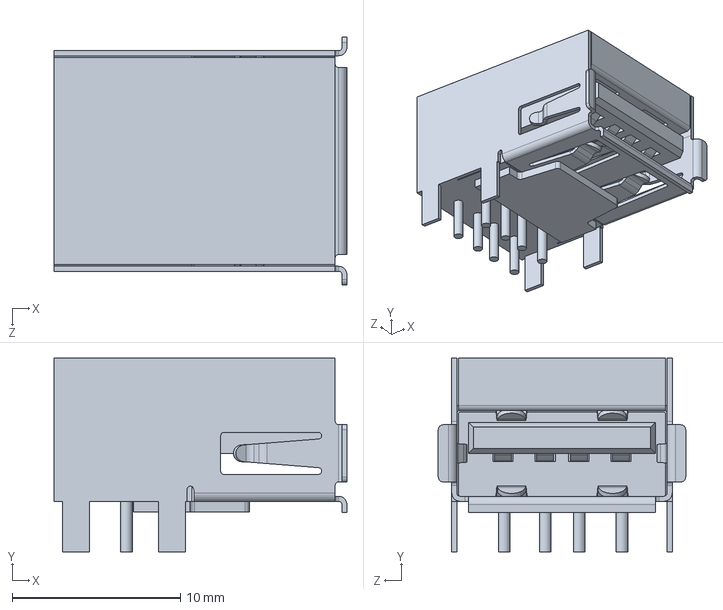
[picture p45: CAD file, 2017-01-25]
hardware/chassis/components/rpi/raspberry_pi_B+_(USB_x2_part2).SLDPRT
17.4 x 11.5 x 14.7 mm
