bahusvel/HAPi-Cluster/hardware/chassis/rail_endstop_3d.SLDPRT

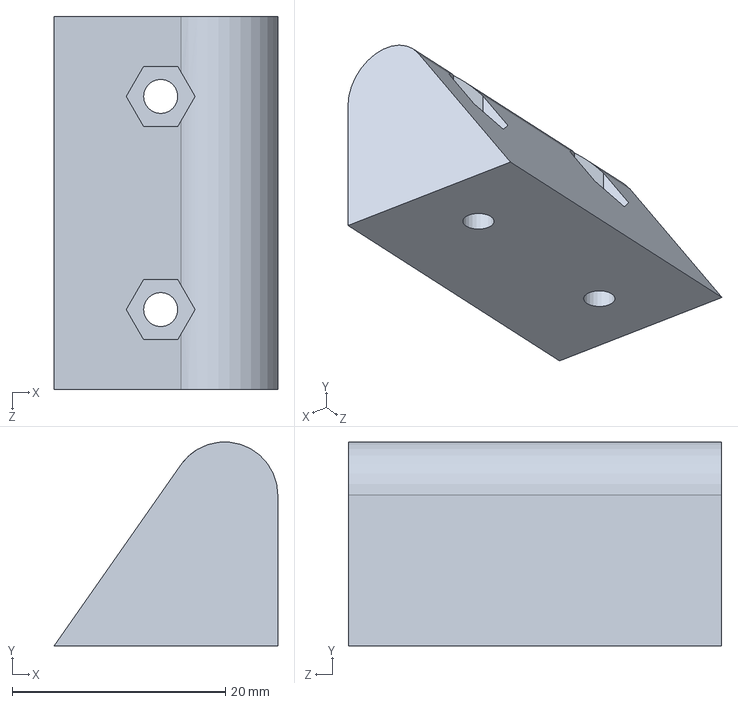
[picture p46: CAD file, 2017-02-10]
hardware/chassis/rail_endstop_3d.SLDPRT
21.0 x 19.1 x 35.0 mm
