bahusvel/HAPi-Cluster/hardware/chassis/components/rpi/raspberry_pi_B+_(QFN64).SLDPRT

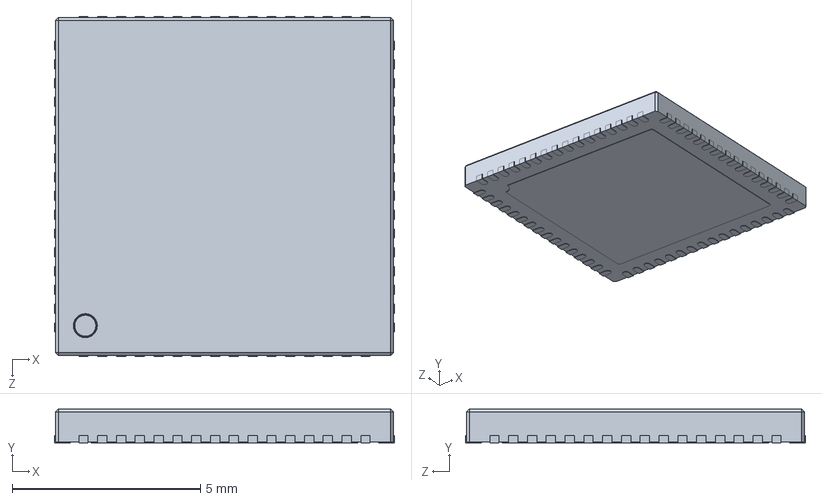
[picture p47: CAD file, 2017-01-25]
hardware/chassis/components/rpi/raspberry_pi_B+_(QFN64).SLDPRT
9.04 x 0.9 x 9.04 mm
