bahusvel/HAPi-Cluster/hardware/chassis/sliding_rail_6mm.SLDPRT

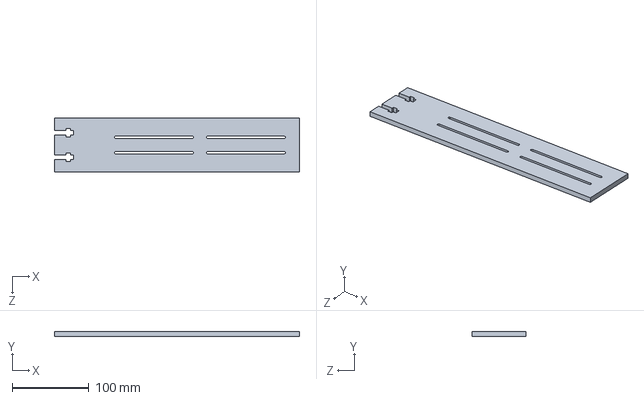
[picture p48: CAD file, 2017-02-10]
hardware/chassis/sliding_rail_6mm.SLDPRT
320.0 x 6.00 x 70.0 mm
