bahusvel/HAPi-Cluster/hardware/chassis/components/rpi/raspberry_pi__HDMI_socket_large_pin.SLDPRT

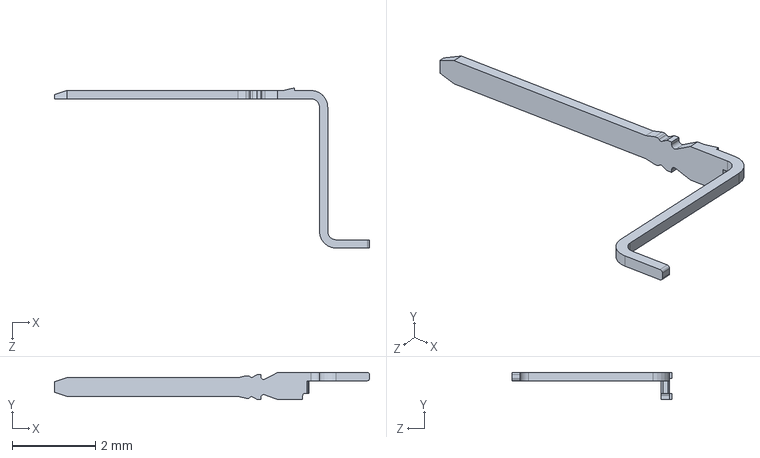
[picture p49: CAD file, 2017-01-25]
hardware/chassis/components/rpi/raspberry_pi__HDMI_socket_large_pin.SLDPRT
7.55 x 0.65 x 3.84 mm
