bahusvel/HAPi-Cluster/hardware/chassis/rail_support_6mm.SLDPRT

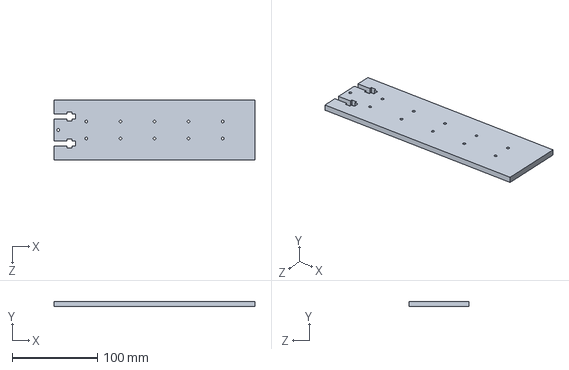
[picture p50: CAD file, 2017-02-10]
hardware/chassis/rail_support_6mm.SLDPRT
236.0 x 6.00 x 70.0 mm
