bahusvel/HAPi-Cluster/hardware/chassis/components/rpi/raspberry_pi__15_pin_FFC_Connector_body.SLDPRT

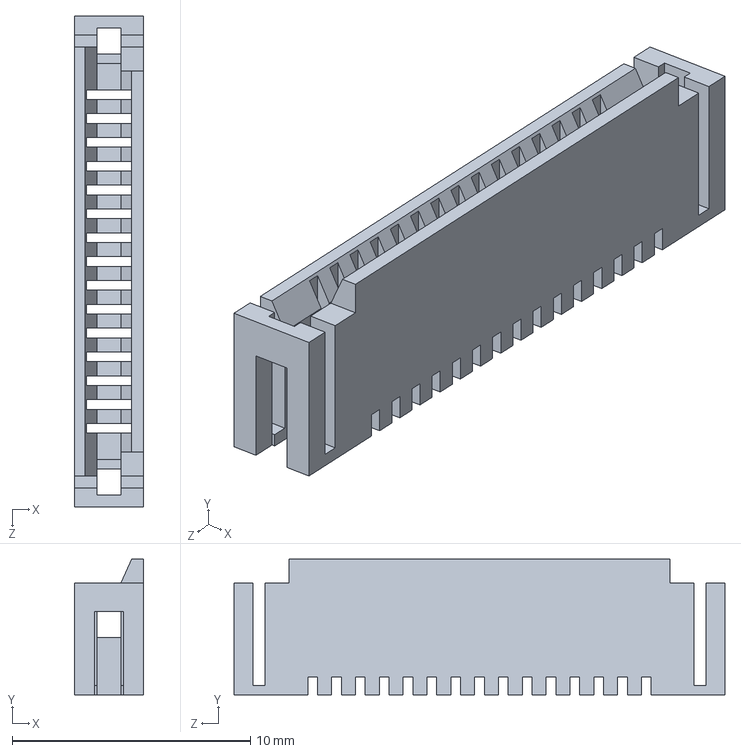
[picture p51: CAD file, 2017-01-25]
hardware/chassis/components/rpi/raspberry_pi__15_pin_FFC_Connector_body.SLDPRT
2.90 x 5.70 x 20.6 mm
