bahusvel/HAPi-Cluster/hardware/chassis/rail_latch_3d.SLDPRT

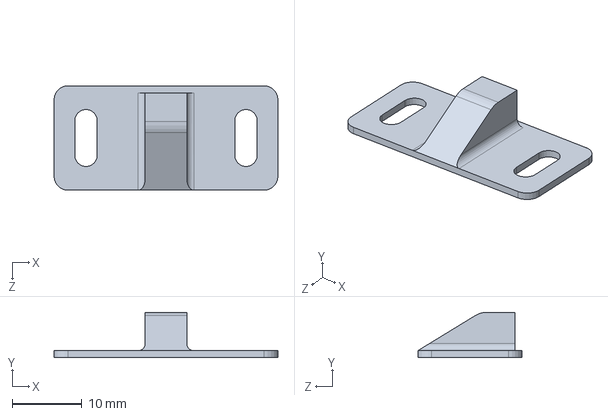
[picture p52: CAD file, 2017-02-10]
hardware/chassis/rail_latch_3d.SLDPRT
32.2 x 6.50 x 15.0 mm
