bahusvel/HAPi-Cluster/hardware/chassis/components/rpi/raspberry_pi_B+_(bar_180_2x20).SLDPRT

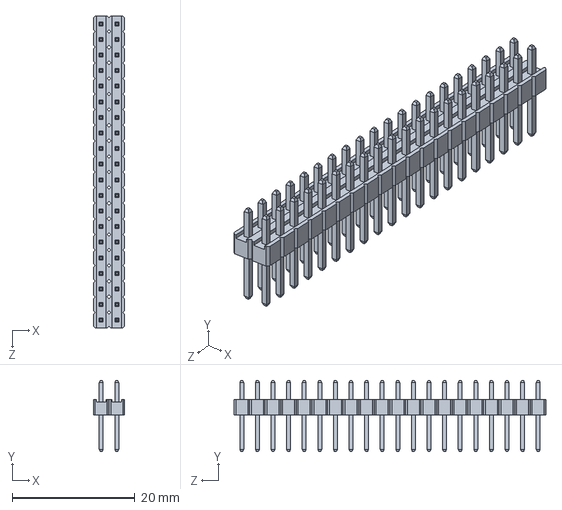
[picture p53: CAD file, 2017-01-25]
hardware/chassis/components/rpi/raspberry_pi_B+_(bar_180_2x20).SLDPRT
5.08 x 11.6 x 50.8 mm
