bahusvel/HAPi-Cluster/hardware/chassis/lid_hinge_3d.SLDPRT

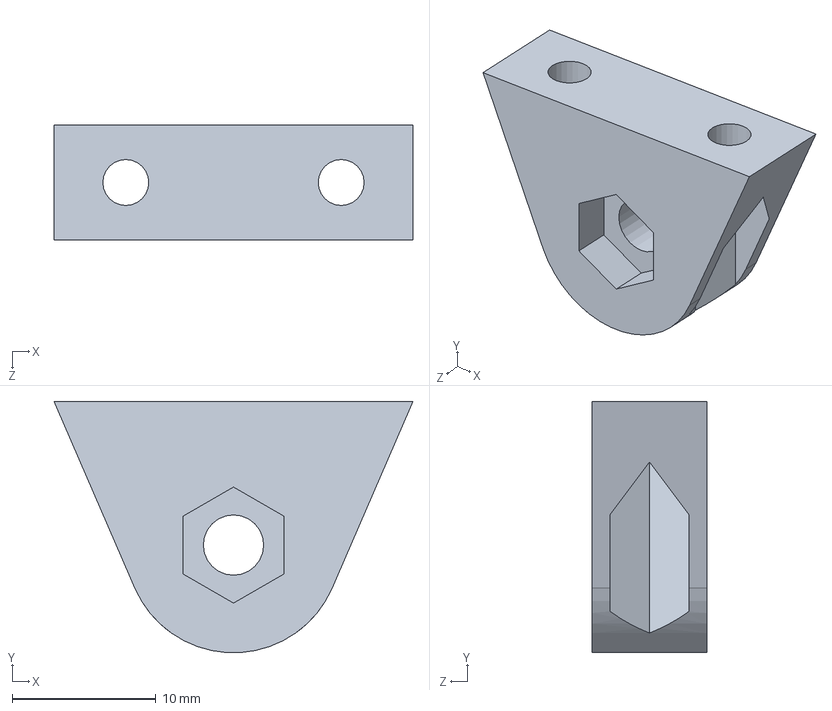
[picture p54: CAD file, 2017-02-08]
hardware/chassis/lid_hinge_3d.SLDPRT
25.0 x 17.5 x 8.00 mm
