bahusvel/HAPi-Cluster/hardware/chassis/3corner_brace_3d.SLDPRT

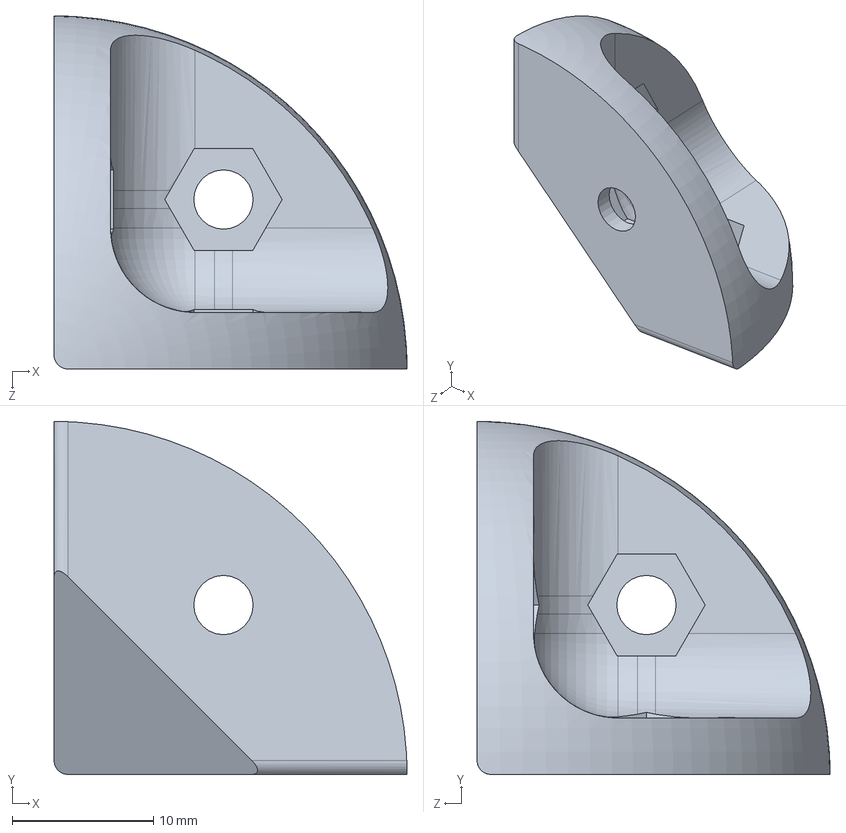
[picture p55: CAD file, 2017-02-03]
hardware/chassis/3corner_brace_3d.SLDPRT
25.0 x 25.0 x 25.0 mm
