bahusvel/HAPi-Cluster/hardware/chassis/components/rpi/raspberry_pi_B+_(RJ45).SLDPRT

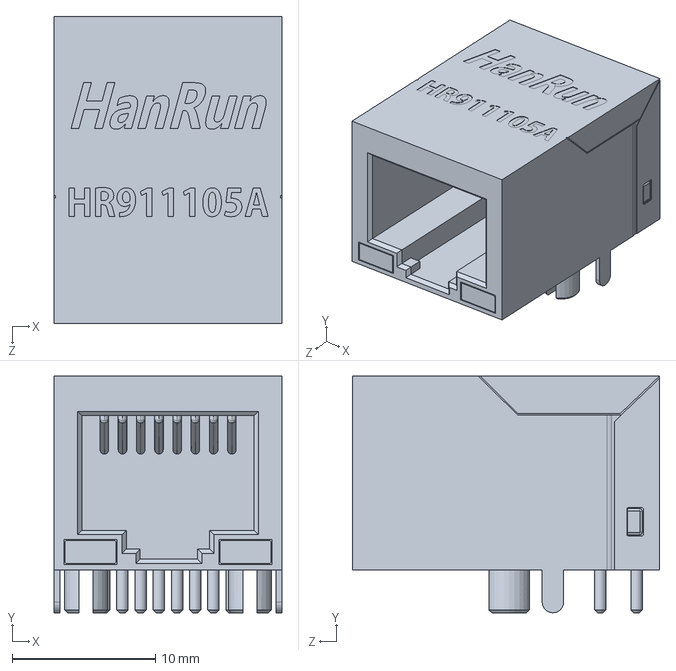
[picture p56: CAD file, 2017-01-25]
hardware/chassis/components/rpi/raspberry_pi_B+_(RJ45).SLDPRT
15.9 x 16.5 x 21.4 mm
