bahusvel/HAPi-Cluster/hardware/chassis/2corner_brace_3d.SLDPRT

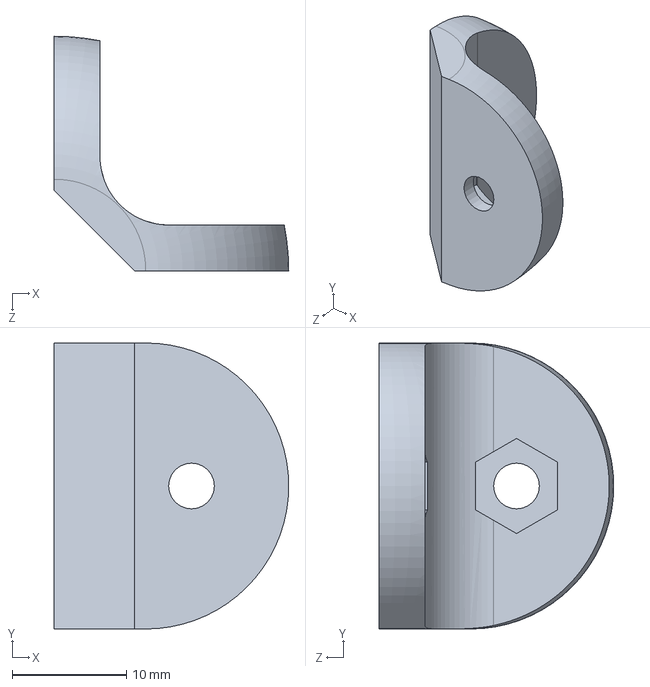
[picture p57: CAD file, 2017-02-03]
hardware/chassis/2corner_brace_3d.SLDPRT
20.5 x 25.0 x 20.5 mm
