bahusvel/HAPi-Cluster/hardware/chassis/components/rpi/raspberry_pi__15_pin_FFC_Connector_pins.SLDPRT

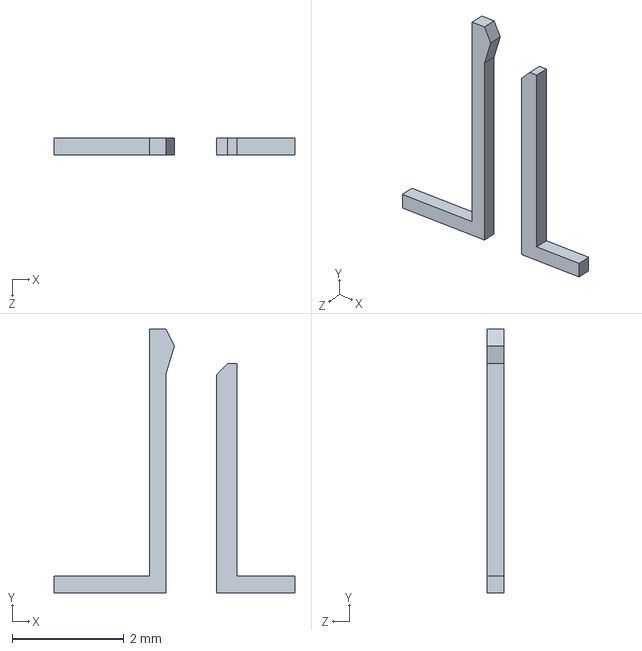
[picture p58: CAD file, 2017-01-25]
hardware/chassis/components/rpi/raspberry_pi__15_pin_FFC_Connector_pins.SLDPRT
4.30 x 4.71 x 0.3 mm
