bahusvel/HAPi-Cluster/hardware/chassis/rpi_holder_3d.SLDPRT

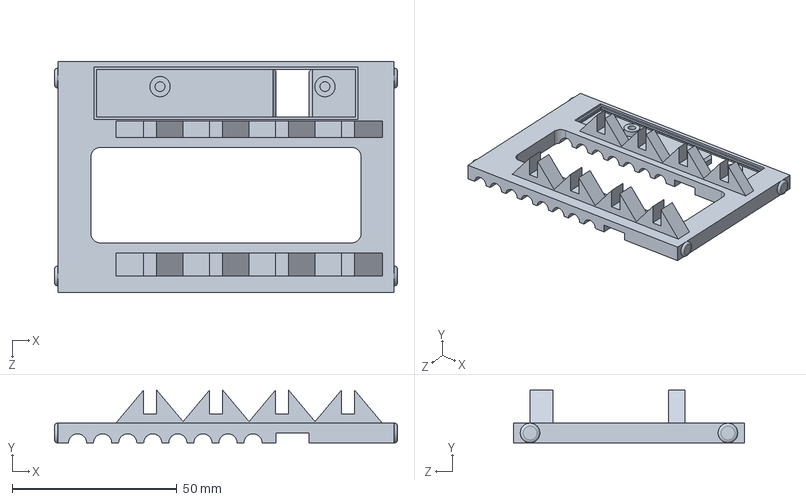
[picture p59: CAD file, 2017-01-30]
hardware/chassis/rpi_holder_3d.SLDPRT
104.0 x 16.0 x 70.0 mm
