bahusvel/HAPi-Cluster/hardware/chassis/cat5e_holder_4_3d.SLDPRT

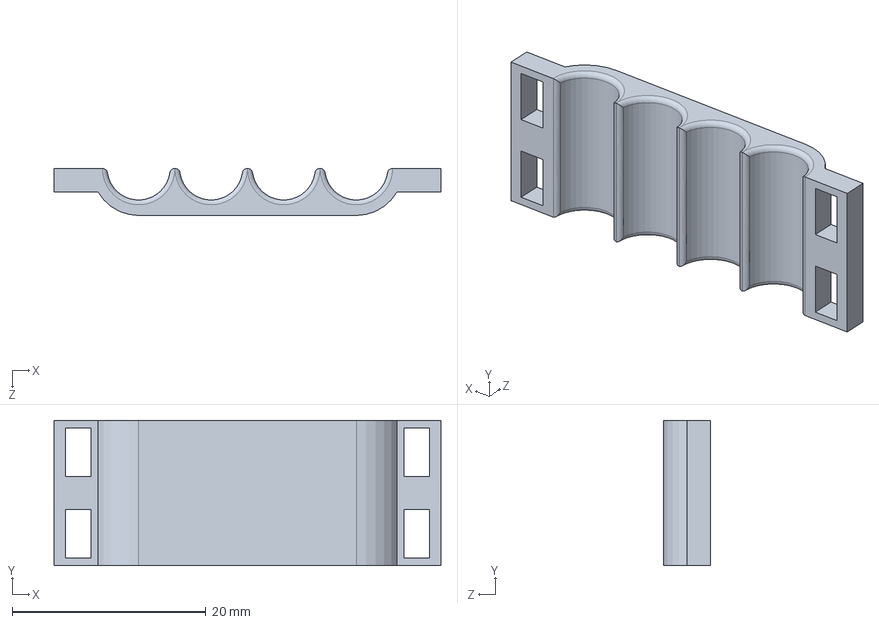
[picture p60: CAD file, 2017-01-17]
hardware/chassis/cat5e_holder_4_3d.SLDPRT
40.0 x 15.0 x 4.85 mm
