bahusvel/HAPi-Cluster/hardware/chassis/cat5e_holder_12_3d.SLDPRT

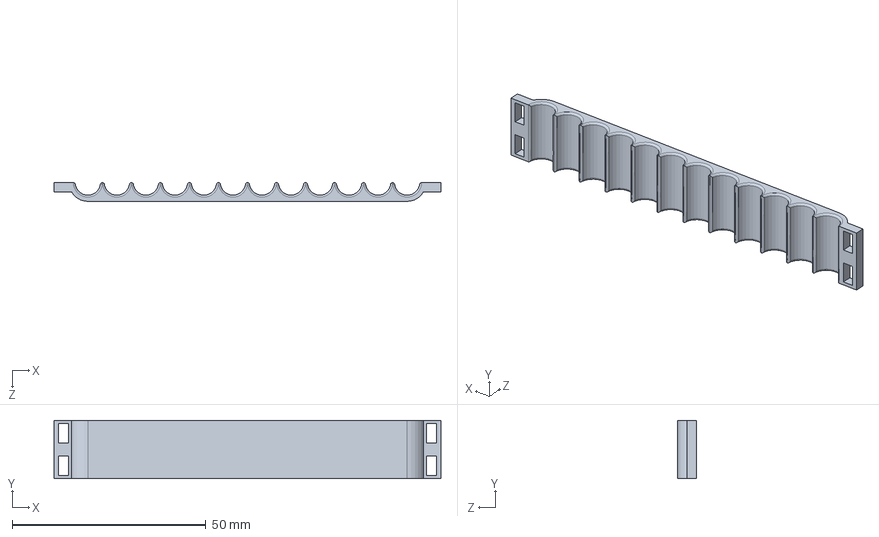
[picture p61: CAD file, 2017-01-17]
hardware/chassis/cat5e_holder_12_3d.SLDPRT
100.0 x 15.0 x 4.85 mm
