bahusvel/HAPi-Cluster/(list of files, cad)

Other CAD files:
hardware/chassis/components/server/User Library-fod-assy_asm_FOD-BP-BD-ST.sldprt
hardware/chassis/components/server/User Library-fod-assy_asm_FOD-PCB-GUIDE.sldprt
hardware/chassis/components/server/User Library-fod-assy_asm_SLIDE-SWITCH.sldprt
hardware/chassis/components/server/User Library-fod-assy_asm_PRT0002.sldprt
hardware/chassis/components/server/User Library-fod-assy_asm_FOD-TOP-COVER.sldprt
hardware/chassis/components/server/User Library-fod-assy_asm_FOD-IO-PANEL.sldprt
hardware/chassis/components/server/User Library-fod-assy_asm_FOD-MAIN-BD.sldprt
hardware/chassis/components/server/User Library-fod-assy_asm_FOD-DESIGN-BAR.sldprt
hardware/chassis/components/server/User Library-fod-assy_asm_FOD-FRONT-BRKT.sldprt
hardware/chassis/components/server/User Library-fod-assy_asm_FOD-FRONT-PANEL.sldprt
hardware/chassis/components/server/User Library-fod-assy_asm_FOD-BASE.sldprt
hardware/chassis/components/server/User Library-fod-assy_asm_FOD-BD-COVER.sldprt
hardware/chassis/components/server/User Library-fod-assy_asm_FOD-SIDE-BRKT.sldprt
hardware/chassis/components/server/User Library-fod-assy_asm_FOD-MODULE-ASSY_ASM.sldasm
hardware/chassis/components/rpi/raspberry_pi_B+_(P1).SLDASM
hardware/chassis/components/fan/sunon_blade_80.sldprt
hardware/chassis/components/rack/19inch Rack In Fill section Front-Rear.sldprt
hardware/chassis/components/rack_backup/19inch Rack In Fill section Front-Rear.sldprt
hardware/chassis/components/fan/sunon_frame.sldprt
hardware/chassis/components/rack/19inch Rack Corner Section x 16U.sldprt
hardware/chassis/components/rack_backup/19inch Rack Corner Section x 16U.sldprt
hardware/chassis/components/rack/19inch Rack In Fill section Side.sldprt
hardware/chassis/components/rack_backup/19inch Rack In Fill section Side.sldprt
hardware/chassis/components/rack/19inch Rack Top.sldprt
hardware/chassis/components/rack_backup/19inch Rack Top.sldprt
hardware/chassis/upper_rail_4mm.SLDPRT
hardware/chassis/railwidth_6mm.sldprt
hardware/chassis/components/fan/sunon_blade_80.ipt
hardware/chassis/components/fan/sunon_fan_red.SLDASM
hardware/chassis/components/fan/sunon_fan_red.iam
hardware/chassis/components/fan/sunon_frame.ipt
hardware/chassis/components/rack/19inch Rack 16U.SLDASM
hardware/chassis/components/rack_backup/19inch Rack 16U.SLDASM
hardware/chassis/components/rpi/raspberry_pi_B+_(microsd).SLDPRT
hardware/chassis/components/rpi/raspberry_pi_B+_(slot).SLDPRT
hardware/chassis/components/server/User Library-fod-assy_asm_CONN-LC-TYPE-SCREW.sldprt
hardware/chassis/components/server/User Library-fod-assy_asm_FOD-CAP-SCREW.sldprt
hardware/chassis/pdf/batch1_6mm.SLDDRW
hardware/chassis/pdf/batch2_6mm.SLDDRW
hardware/chassis/pdf/batch3_4mm.SLDDRW
hardware/chassis/stl/3corner_brace_3d.STL
hardware/chassis/stl/3u_handle_3D.STL
hardware/chassis/stl/cat5e_holder_12_3d.STL
hardware/chassis/stl/cat5e_holder_4_3d.STL
hardware/chassis/stl/cat5e_holder_8_3d.STL
hardware/chassis/stl/rpi_holder_3d.STL
