bahusvel/HAPi-Cluster/hardware/chassis/pdf/front_grill_cut_6mm.PDF

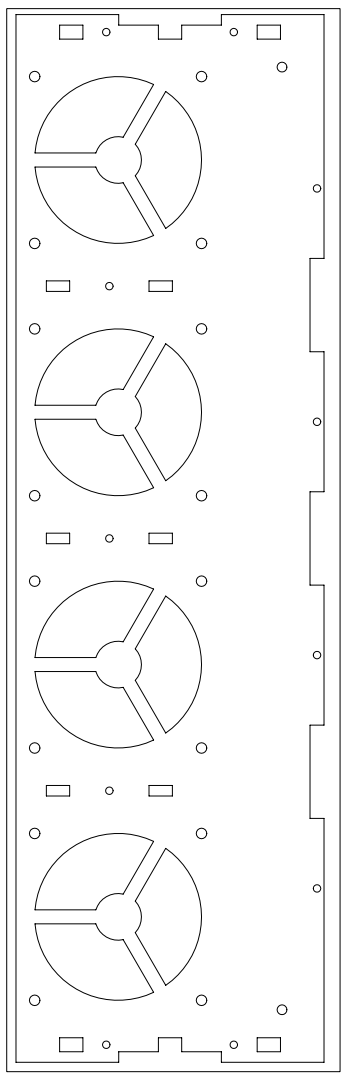
[picture p63: page 1]
