bahusvel/HAPi-Cluster/hardware/chassis/pdf/front_grill_engrave_6mm.pdf

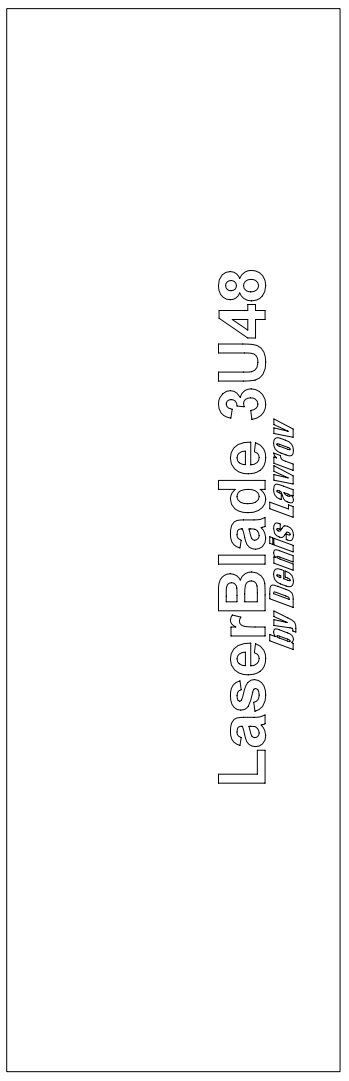
[picture p64: page 1]
