bahusvel/HAPi-Cluster/hardware/chassis/pdf/batch1_cut_6mm.PDF

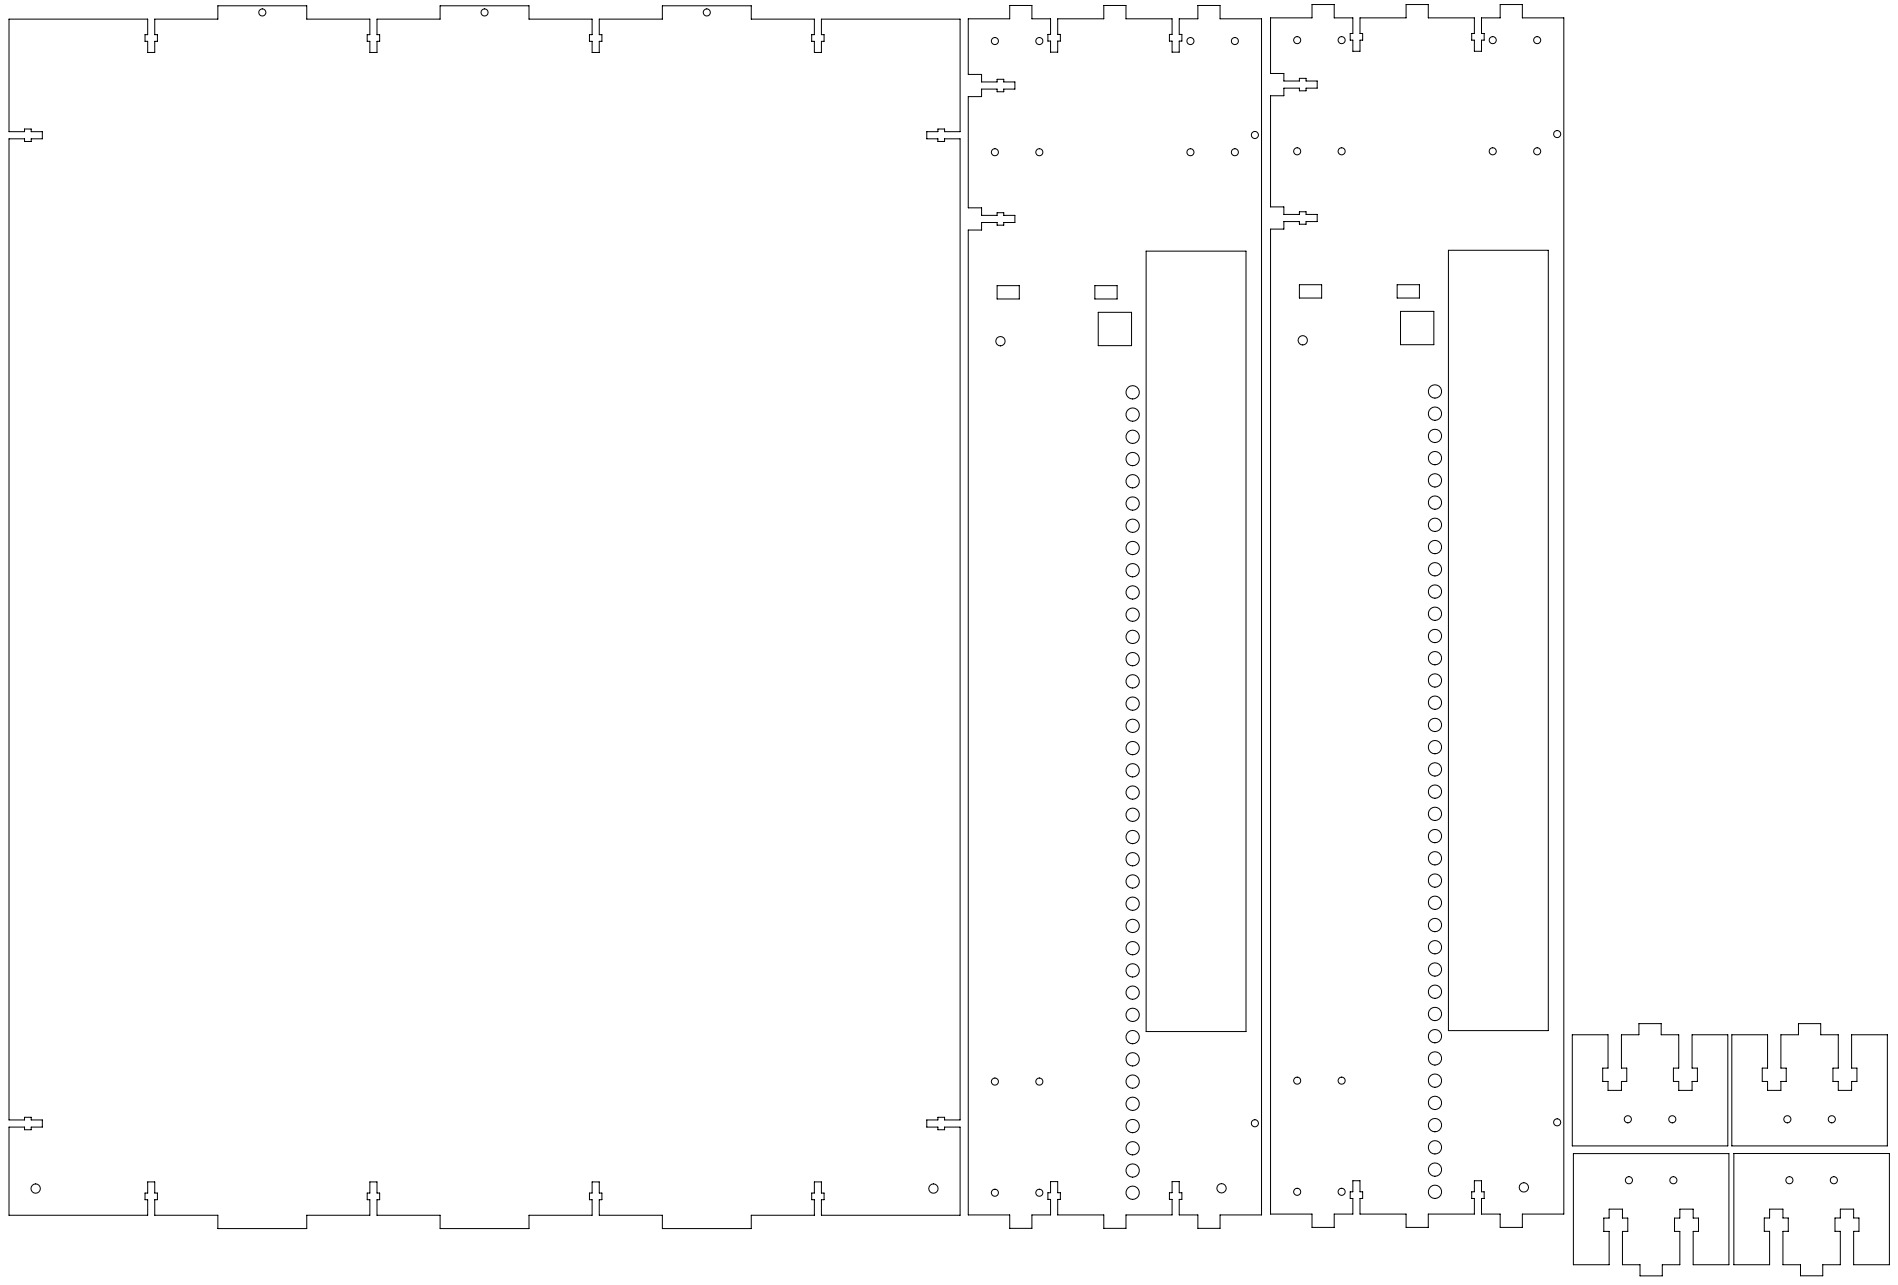
[picture p65: page 1]
