bahusvel/HAPi-Cluster/hardware/chassis/pdf/batch2_cut_6mm.PDF

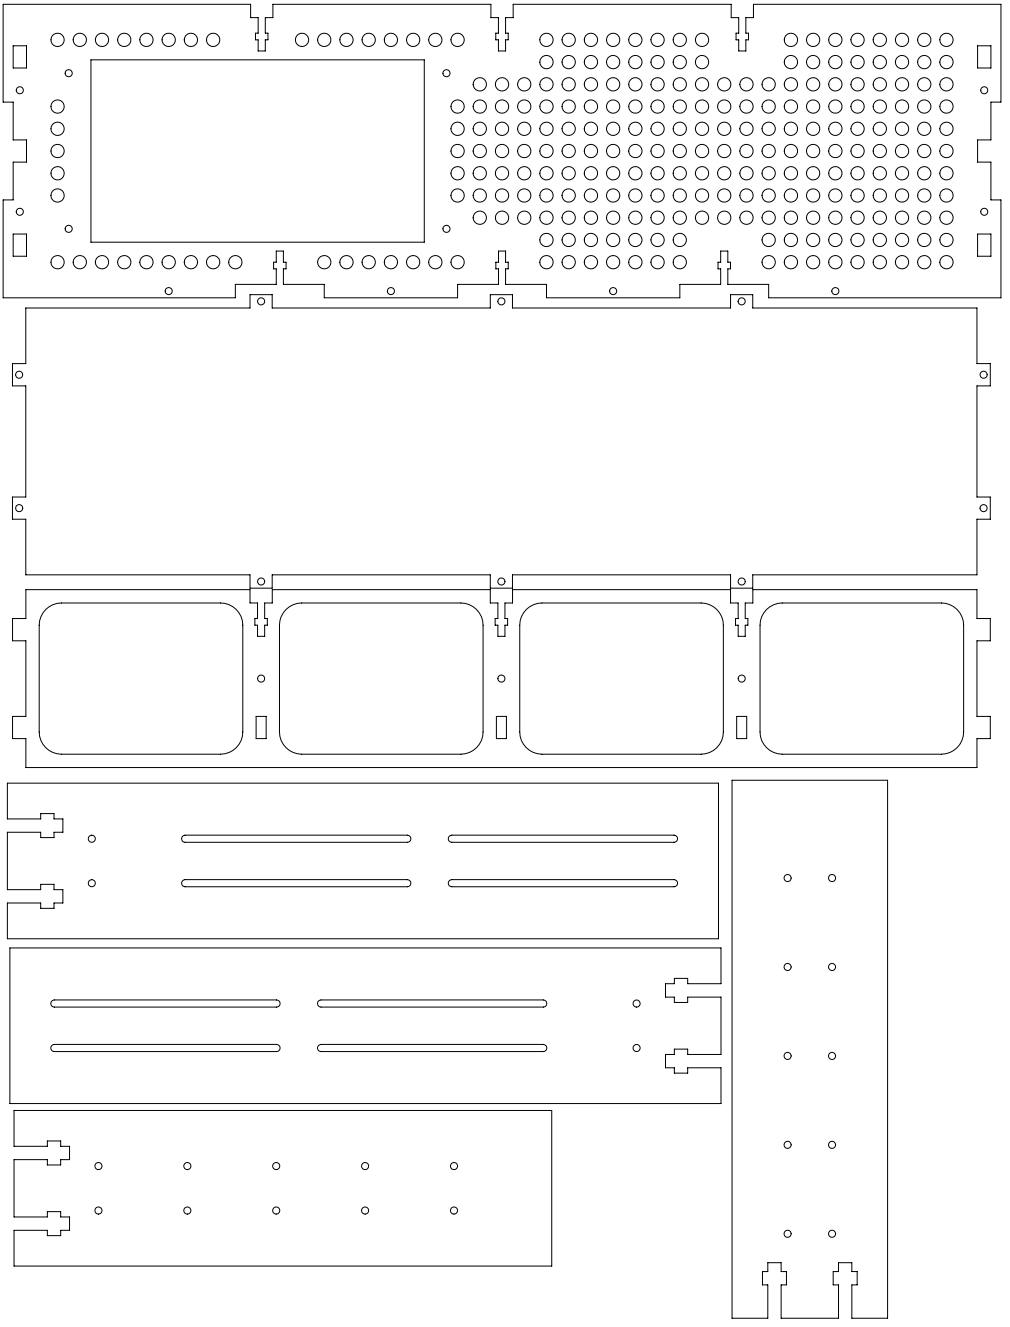
[picture p66: page 1]
