bahusvel/HAPi-Cluster/hardware/chassis/pdf/batch3_cut_4mm.PDF

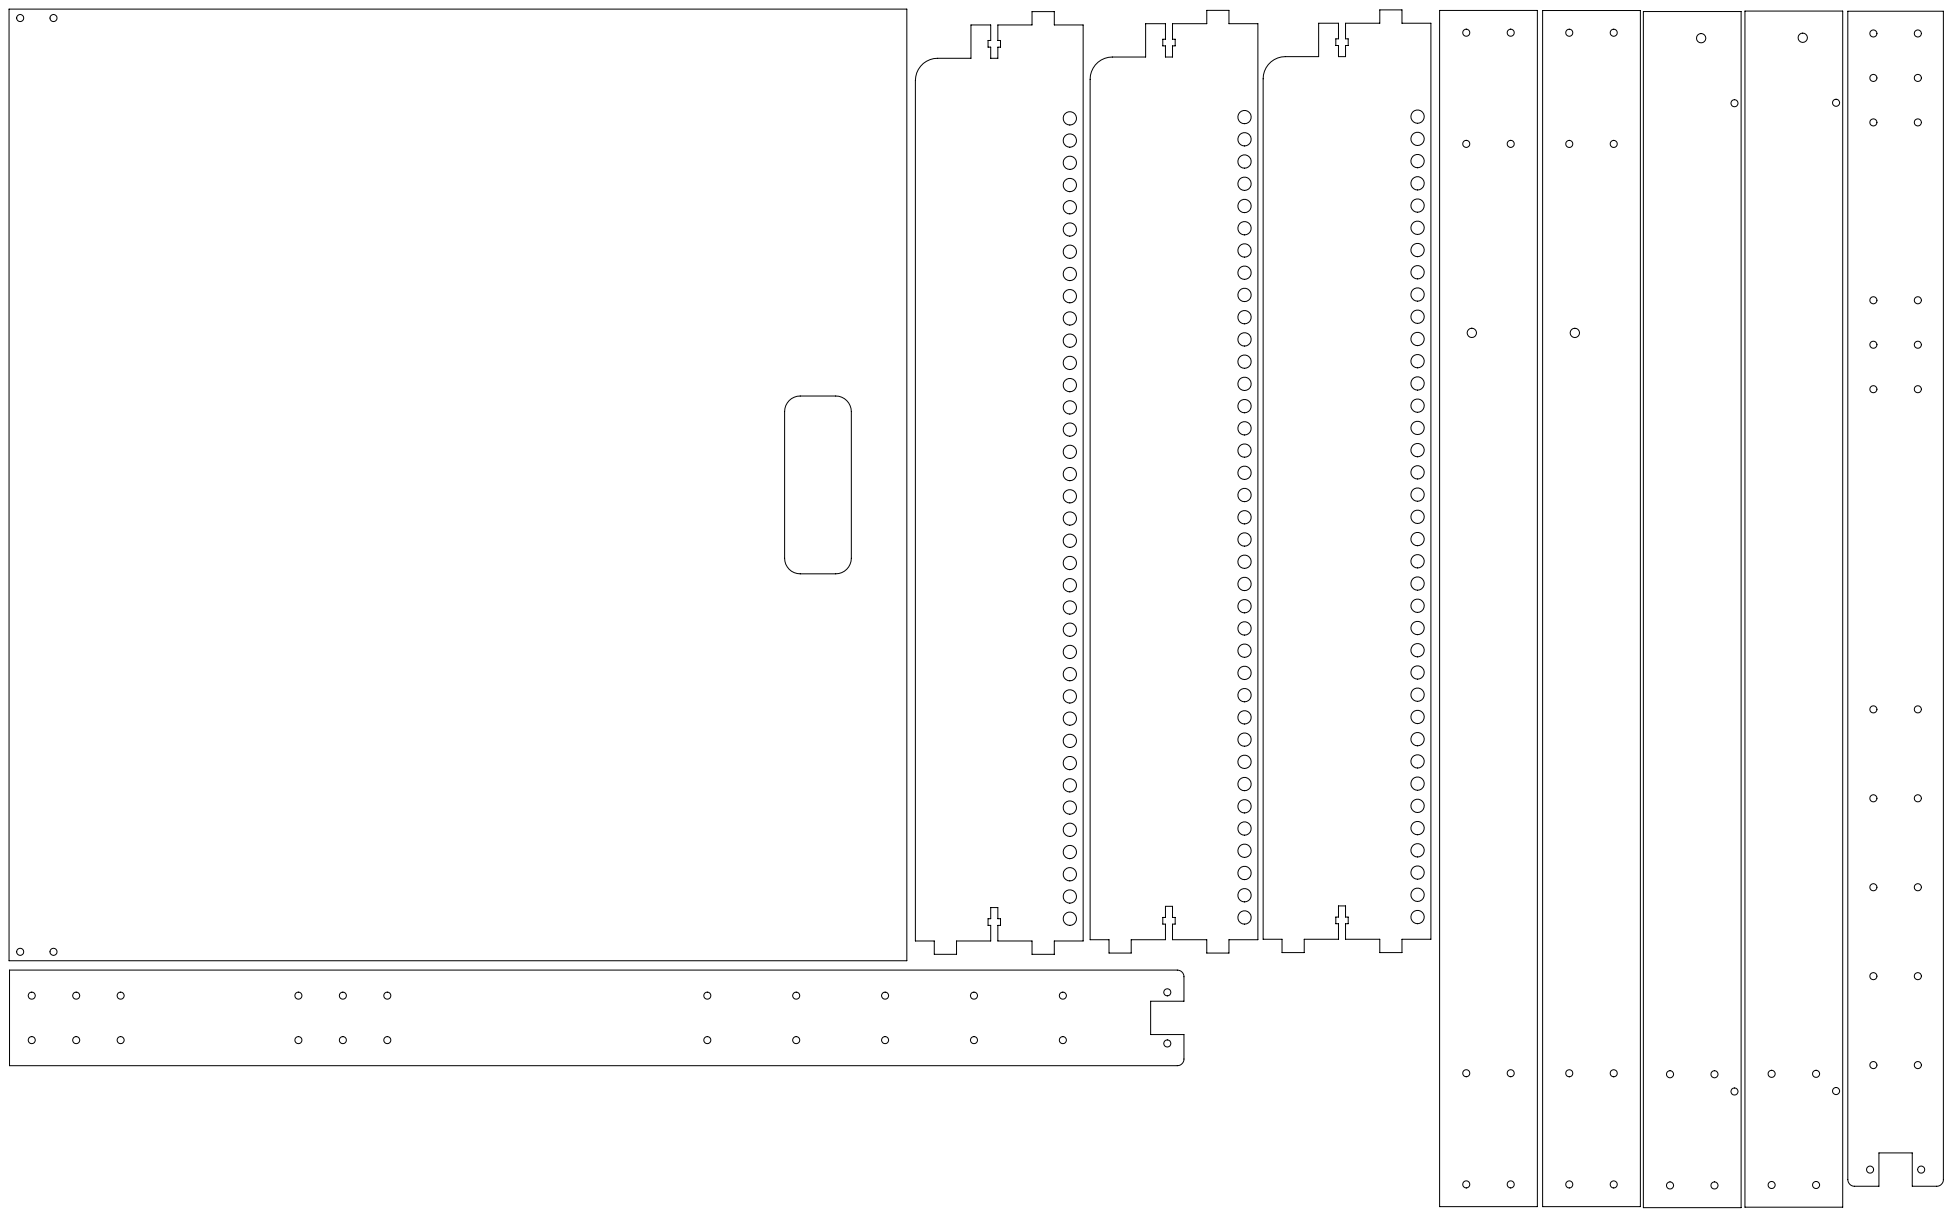
[picture p67: page 1]
