bahusvel/HAPi-Cluster/hardware/chassis/pdf/front_cut_6mm.pdf

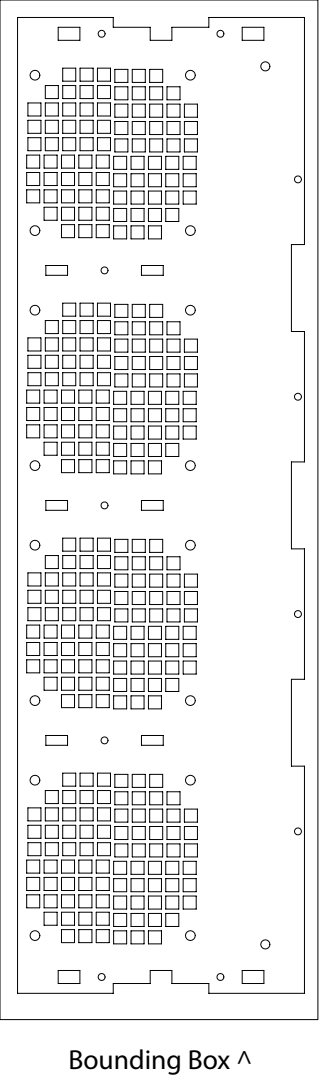
[picture p68: page 1]
Bounding Box ^
