bahusvel/HAPi-Cluster/hardware/chassis/pdf/front_engrave_6mm.pdf

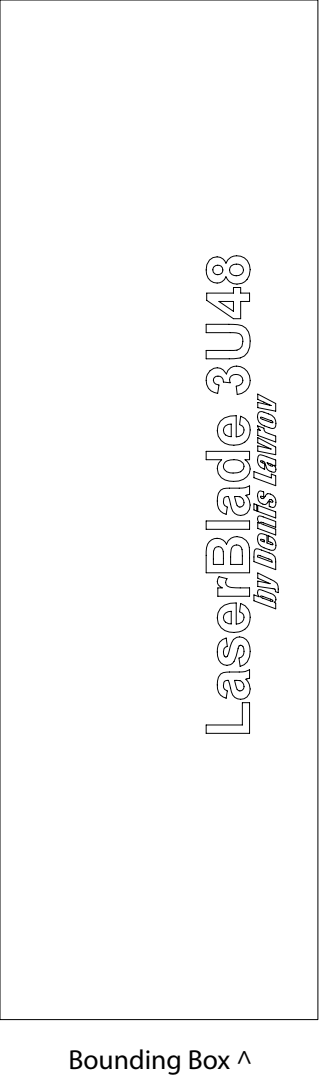
[picture p69: page 1]
Bounding Box ^
