bahusvel/HAPi-Cluster/hardware/pcdu/net_breakout_rev1_0/rev1_0.brd

## EAGLE design hardware/pcdu/net_breakout_rev1_0/rev1_0.brd (2017-03-10)

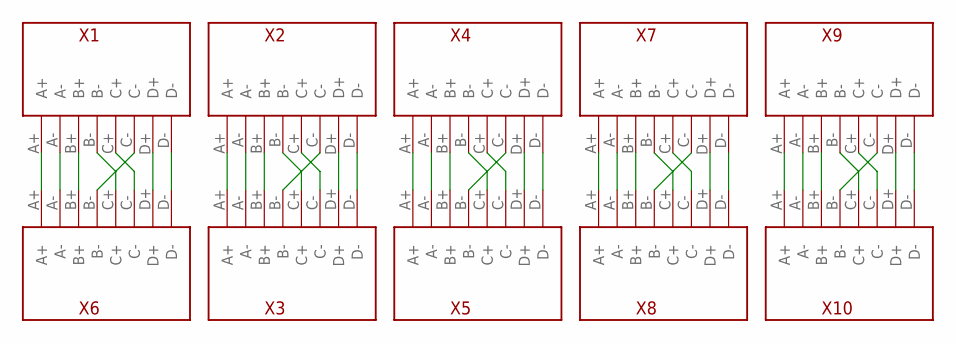
[picture p70: schematic rev1_0.sch]

Parts:
X1, X2, X3, X4, X5, X6, X7, X8, X9, X10: ETHER_BRKOUT

Connections:
unnamed: X1.A+, X6.A+
unnamed: X1.A-, X6.A-
unnamed: X1.B+, X6.B+
unnamed: X1.C-, X6.B-
unnamed: X1.B-, X6.C+
unnamed: X1.C+, X6.C-
unnamed: X1.D+, X6.D+
unnamed: X1.D-, X6.D-
unnamed: X2.A+, X3.A+
unnamed: X2.A-, X3.A-
unnamed: X2.B+, X3.B+
unnamed: X2.C-, X3.B-
unnamed: X2.B-, X3.C+
unnamed: X2.C+, X3.C-
unnamed: X2.D+, X3.D+
unnamed: X2.D-, X3.D-
unnamed: X4.A+, X5.A+
unnamed: X4.A-, X5.A-
unnamed: X4.B+, X5.B+
unnamed: X4.C-, X5.B-
unnamed: X4.B-, X5.C+
unnamed: X4.C+, X5.C-
unnamed: X4.D+, X5.D+
unnamed: X4.D-, X5.D-
unnamed: X7.A+, X8.A+
unnamed: X7.A-, X8.A-
unnamed: X7.B+, X8.B+
unnamed: X7.C-, X8.B-
unnamed: X7.B-, X8.C+
unnamed: X7.C+, X8.C-
unnamed: X7.D+, X8.D+
unnamed: X7.D-, X8.D-
unnamed: X9.A+, X10.A+
unnamed: X9.A-, X10.A-
unnamed: X9.B+, X10.B+
unnamed: X9.C-, X10.B-
unnamed: X9.B-, X10.C+
unnamed: X9.C+, X10.C-
unnamed: X9.D+, X10.D+
unnamed: X9.D-, X10.D-

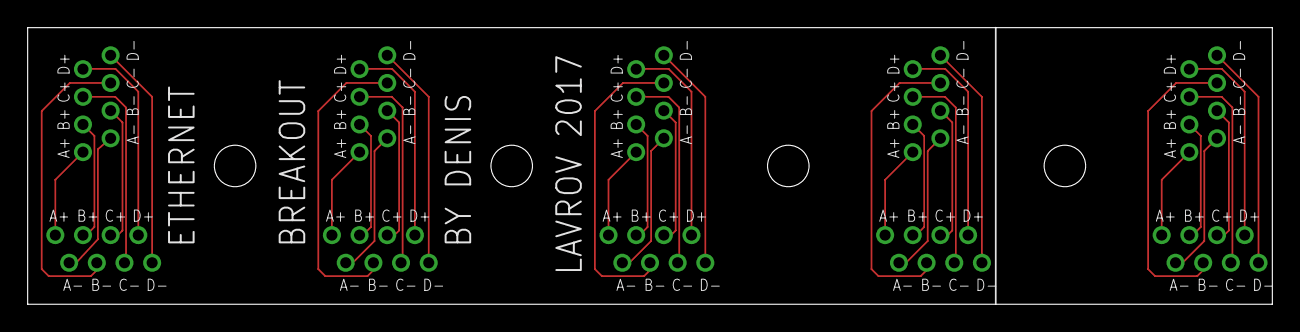
[picture p71: board hardware/pcdu/net_breakout_rev1_0/rev1_0.brd from above]

Board: 2 copper layers, 90.0 x 20.0 mm, 10 parts (0 on the bottom side), 40 nets.
