bahusvel/HAPi-Cluster/hardware/pcdu/vhdb_rev1_0/rev1_0.brd

## EAGLE design hardware/pcdu/vhdb_rev1_0/rev1_0.brd (2017-02-19, an earlier design)

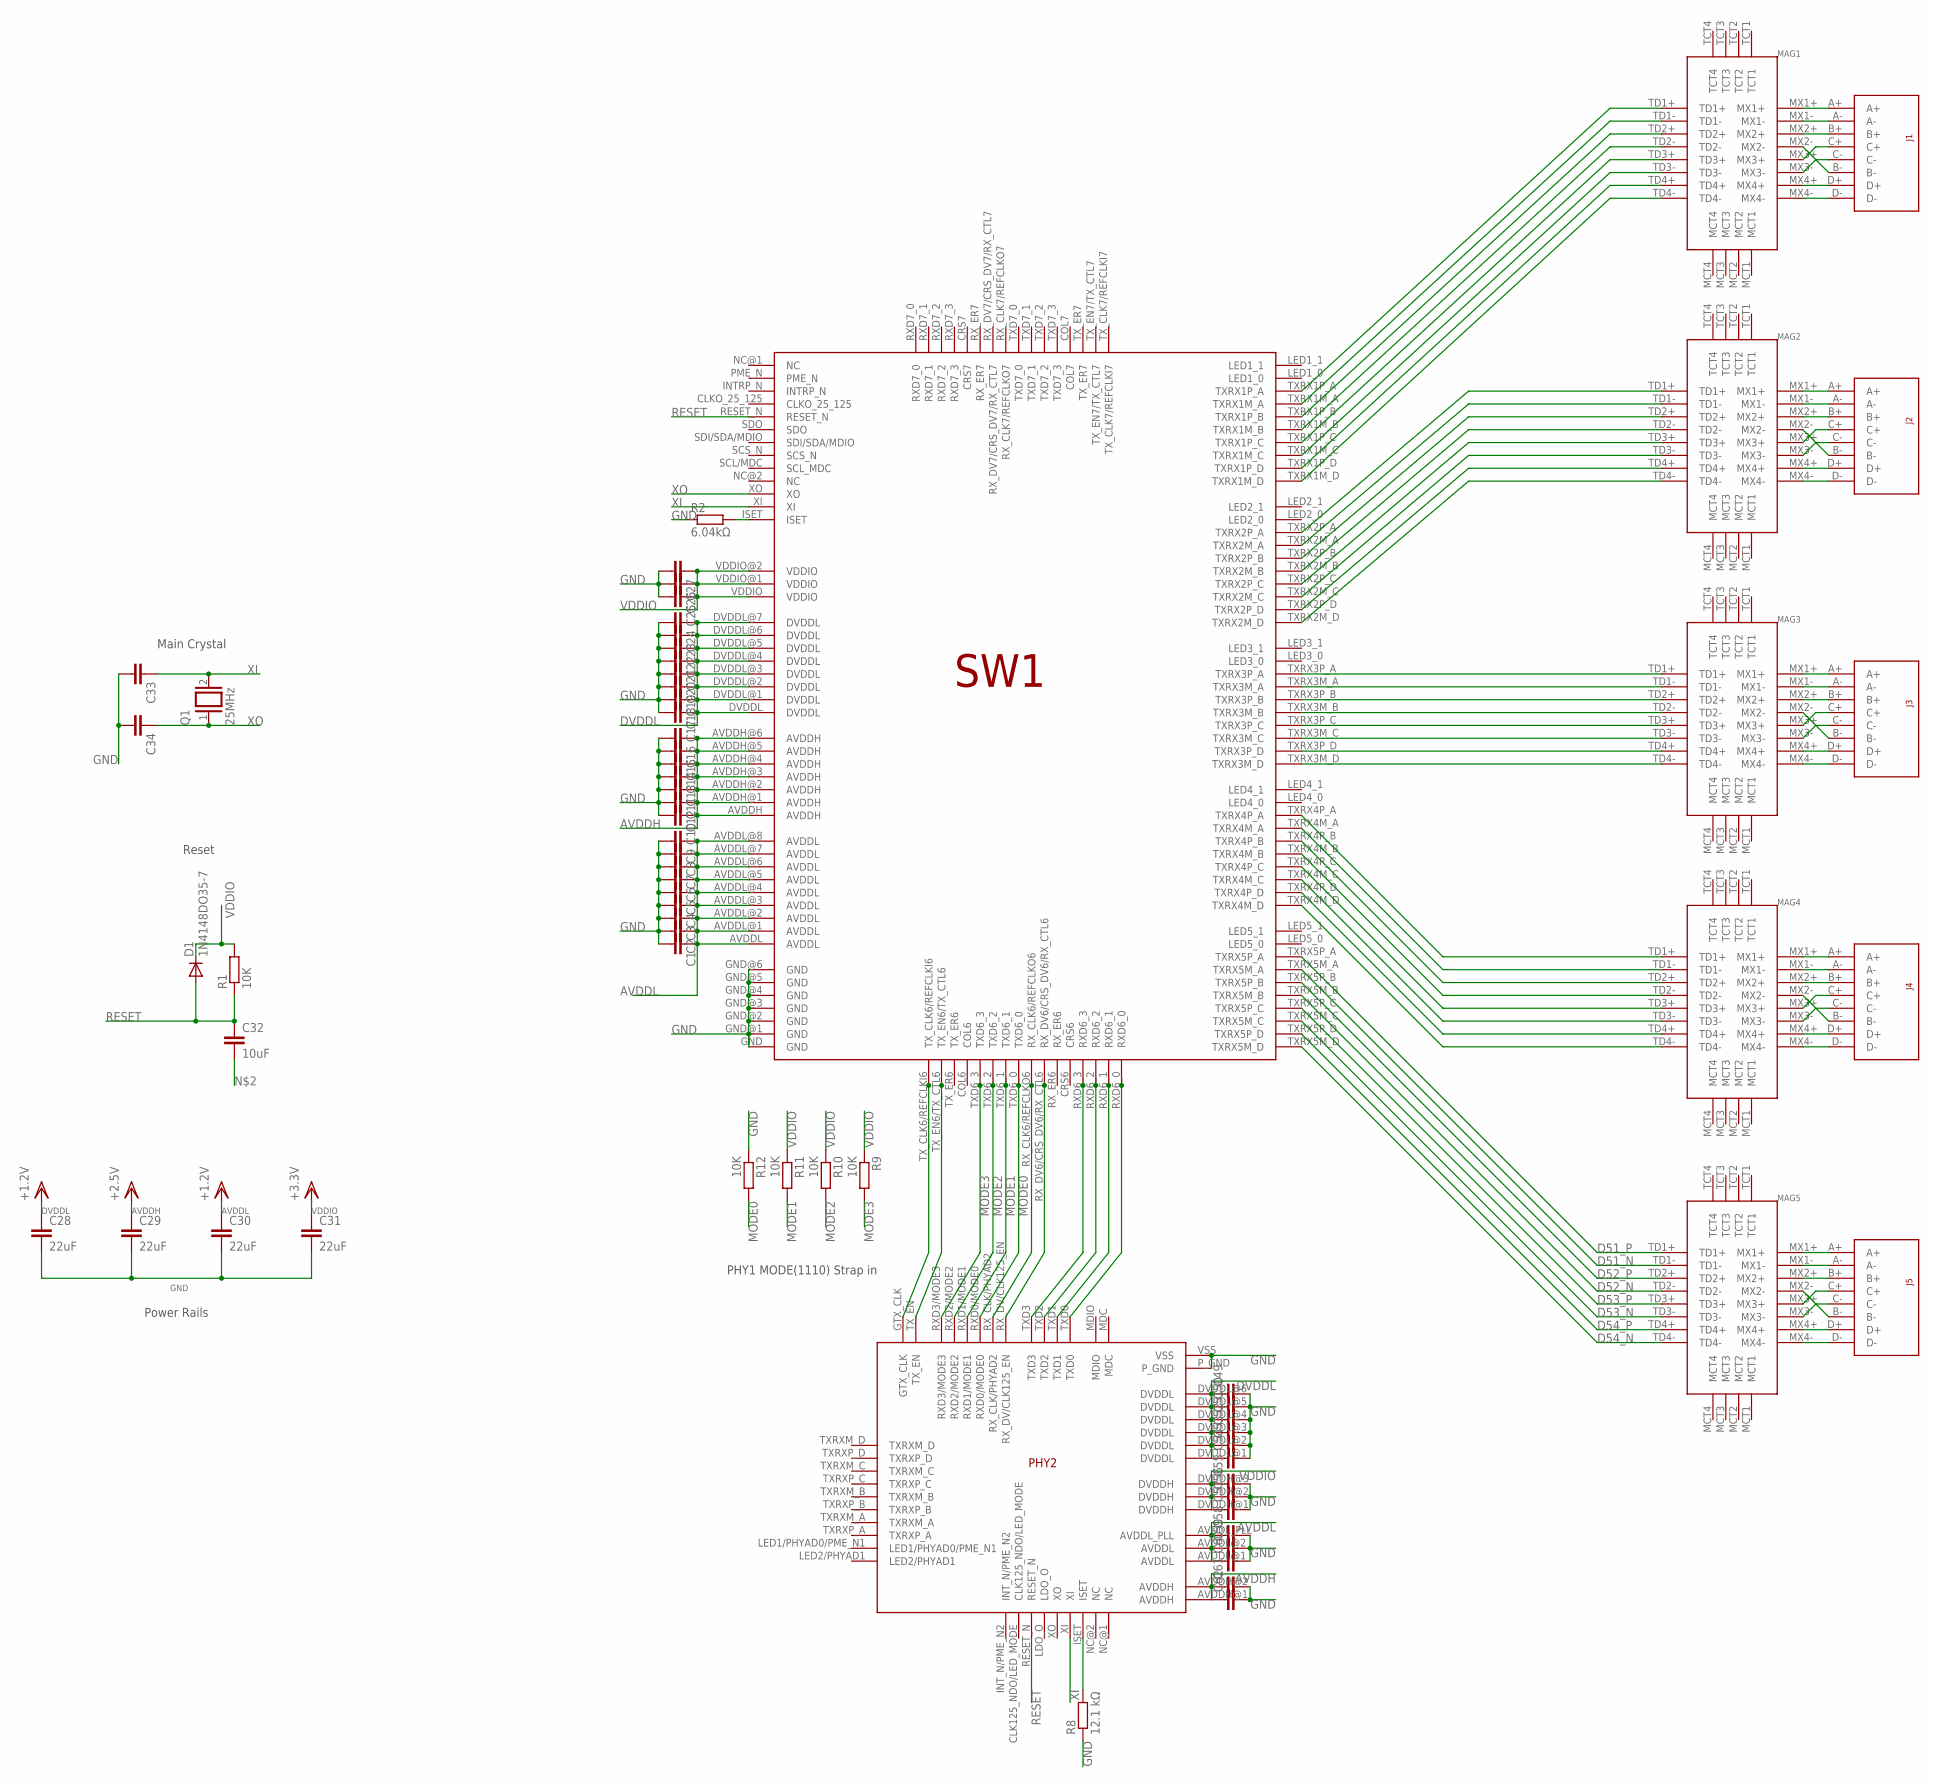
[picture p72: schematic rev1_0.sch]

Parts:
C1, C2, C3, C4, C5, C6, C7, C8, C9, C10, C11, C12, C13, C14, C15, C16, C17, C18, C19, C20, C21, C22, C23, C24, C25, C26, C27, C33, C34, C49, C50, C51, C52, C53, C54, C55, C56, C57, C58, C59, C60, C61, C62: C-EUC0805; C0805
C28, C29, C30, C31: 22uF; C0805
C32: 10uF; C0805
D1: 1N4148DO35-7; DO35-7
J1, J2, J3, J4, J5: AJP92A8813
MAG1, MAG2, MAG3, MAG4, MAG5: 749020010A; 749023010A
PHY2: KSZ9031RNX
Q1: 25MHz; QS
R1, R9, R10, R11, R12: 10K; R0805
R2: 6.04kΩ; R0805
R8: 12.1 kΩ; R0805
SW1: KSZ9897RTXC

Connections:
AVDDH: C10.1, C11.1, C12.1, C13.1, C14.1, C15.1, C16.1, C29.1, PHY2.AVDDH@1 (AVDDH), PHY2.AVDDH@2 (AVDDH), SW1.AVDDH, SW1.AVDDH@1 (AVDDH), SW1.AVDDH@2 (AVDDH), SW1.AVDDH@3 (AVDDH), SW1.AVDDH@4 (AVDDH), SW1.AVDDH@5 (AVDDH), SW1.AVDDH@6 (AVDDH)
AVDDL: C1.1, C2.1, C3.1, C4.1, C5.1, C6.1, C7.1, C8.1, C9.1, C30.1, PHY2.AVDDL@1 (AVDDL), PHY2.AVDDL@2 (AVDDL), PHY2.AVDDL_PLL, SW1.AVDDL, SW1.AVDDL@1 (AVDDL), SW1.AVDDL@2 (AVDDL), SW1.AVDDL@3 (AVDDL), SW1.AVDDL@4 (AVDDL), SW1.AVDDL@5 (AVDDL), SW1.AVDDL@6 (AVDDL), SW1.AVDDL@7 (AVDDL), SW1.AVDDL@8 (AVDDL)
D51_N: MAG5.TD1-, SW1.TXRX5M_A
D51_P: MAG5.TD1+, SW1.TXRX5P_A
D52_N: MAG5.TD2-, SW1.TXRX5M_B
D52_P: MAG5.TD2+, SW1.TXRX5P_B
D53_N: MAG5.TD3-, SW1.TXRX5M_C
D53_P: MAG5.TD3+, SW1.TXRX5P_C
D54_N: MAG5.TD4-, SW1.TXRX5M_D
D54_P: MAG5.TD4+, SW1.TXRX5P_D
DVDDL: C17.1, C24.1, C28.1, C49.1, PHY2.DVDDL@1 (DVDDL), PHY2.DVDDL@2 (DVDDL), PHY2.DVDDL@3 (DVDDL), PHY2.DVDDL@4 (DVDDL), PHY2.DVDDL@5 (DVDDL), PHY2.DVDDL@6 (DVDDL), SW1.DVDDL, SW1.DVDDL@1 (DVDDL), SW1.DVDDL@2 (DVDDL), SW1.DVDDL@3 (DVDDL), SW1.DVDDL@4 (DVDDL), SW1.DVDDL@5 (DVDDL), SW1.DVDDL@6 (DVDDL), SW1.DVDDL@7 (DVDDL)
GND: C1.2, C2.2, C3.2, C4.2, C5.2, C6.2, C7.2, C8.2, C9.2, C10.2, C11.2, C12.2, C13.2, C14.2, C15.2, C16.2, C17.2, C18.2, C19.2, C20.2, C21.2, C22.2, C23.2, C24.2, C25.2, C26.2, C27.2, C28.2, C29.2, C30.2, C31.2, C33.2, C34.2, C49.2, C51.2, C52.2, C53.2, C54.2, C55.2, C57.2, C58.2, C60.2, C61.2, C62.2, PHY2.P_GND, PHY2.VSS, R2.1, R8.1, R12.1, SW1.GND, SW1.GND@1 (GND), SW1.GND@2 (GND), SW1.GND@3 (GND), SW1.GND@4 (GND), SW1.GND@5 (GND), SW1.GND@6 (GND)
MODE0: PHY2.RXD0/MODE0, R12.2, SW1.TXD6_0
MODE1: PHY2.RXD1/MODE1, R11.2, SW1.TXD6_1
MODE2: PHY2.RXD2/MODE2, R10.2, SW1.TXD6_2
MODE3: PHY2.RXD3/MODE3, R9.2, SW1.TXD6_3
unnamed: MAG1.TD1+, SW1.TXRX1P_A
unnamed: MAG1.TD1-, SW1.TXRX1M_A
unnamed: MAG1.TD2+, SW1.TXRX1P_B
unnamed: MAG1.TD2-, SW1.TXRX1M_B
unnamed: R2.2, SW1.ISET
unnamed: MAG1.TD3+, SW1.TXRX1P_C
unnamed: MAG1.TD3-, SW1.TXRX1M_C
unnamed: MAG1.TD4+, SW1.TXRX1P_D
unnamed: MAG1.TD4-, SW1.TXRX1M_D
unnamed: MAG2.TD1+, SW1.TXRX2P_A
unnamed: MAG2.TD1-, SW1.TXRX2M_A
unnamed: MAG2.TD2+, SW1.TXRX2P_B
unnamed: MAG2.TD2-, SW1.TXRX2M_B
unnamed: MAG2.TD3+, SW1.TXRX2P_C
unnamed: MAG2.TD3-, SW1.TXRX2M_C
unnamed: MAG2.TD4+, SW1.TXRX2P_D
unnamed: MAG2.TD4-, SW1.TXRX2M_D
unnamed: MAG3.TD1+, SW1.TXRX3P_A
unnamed: MAG3.TD1-, SW1.TXRX3M_A
unnamed: MAG3.TD2+, SW1.TXRX3P_B
unnamed: MAG3.TD2-, SW1.TXRX3M_B
unnamed: MAG3.TD3+, SW1.TXRX3P_C
unnamed: MAG3.TD3-, SW1.TXRX3M_C
unnamed: MAG3.TD4+, SW1.TXRX3P_D
unnamed: MAG3.TD4-, SW1.TXRX3M_D
unnamed: MAG4.TD4-, SW1.TXRX4M_D
unnamed: MAG4.TD4+, SW1.TXRX4P_D
unnamed: MAG4.TD3-, SW1.TXRX4M_C
unnamed: MAG4.TD3+, SW1.TXRX4P_C
unnamed: MAG4.TD2-, SW1.TXRX4M_B
unnamed: MAG4.TD2+, SW1.TXRX4P_B
unnamed: MAG4.TD1-, SW1.TXRX4M_A
unnamed: MAG4.TD1+, SW1.TXRX4P_A
unnamed: J1.A+, MAG1.MX1+
unnamed: J1.A-, MAG1.MX1-
unnamed: J1.B+, MAG1.MX2+
unnamed: J1.B-, MAG1.MX2-
unnamed: J1.C+, MAG1.MX3+
unnamed: J1.C-, MAG1.MX3-
unnamed: J1.D+, MAG1.MX4+
unnamed: J1.D-, MAG1.MX4-
unnamed: J2.A+, MAG2.MX1+
unnamed: J2.A-, MAG2.MX1-
unnamed: J2.B+, MAG2.MX2+
unnamed: J2.B-, MAG2.MX2-
unnamed: J2.C+, MAG2.MX3+
unnamed: J2.C-, MAG2.MX3-
unnamed: J2.D+, MAG2.MX4+
unnamed: J2.D-, MAG2.MX4-
unnamed: J3.A+, MAG3.MX1+
unnamed: J3.A-, MAG3.MX1-
unnamed: J3.B+, MAG3.MX2+
unnamed: J3.B-, MAG3.MX2-
unnamed: J3.C+, MAG3.MX3+
unnamed: J3.C-, MAG3.MX3-
unnamed: J3.D+, MAG3.MX4+
unnamed: J3.D-, MAG3.MX4-
unnamed: J4.A+, MAG4.MX1+
unnamed: J4.A-, MAG4.MX1-
unnamed: J4.B+, MAG4.MX2+
unnamed: J4.B-, MAG4.MX2-
unnamed: J4.C+, MAG4.MX3+
unnamed: J4.C-, MAG4.MX3-
unnamed: J4.D+, MAG4.MX4+
unnamed: J4.D-, MAG4.MX4-
unnamed: J5.A+, MAG5.MX1+
unnamed: J5.A-, MAG5.MX1-
unnamed: J5.B+, MAG5.MX2+
unnamed: J5.B-, MAG5.MX2-
unnamed: J5.C+, MAG5.MX3+
unnamed: J5.C-, MAG5.MX3-
unnamed: J5.D+, MAG5.MX4+
unnamed: J5.D-, MAG5.MX4-
unnamed: PHY2.TXD0, SW1.RXD6_0
unnamed: PHY2.TXD1, SW1.RXD6_1
unnamed: PHY2.TXD2, SW1.RXD6_2
unnamed: PHY2.TXD3, SW1.RXD6_3
unnamed: PHY2.RX_DV/CLK125_EN, SW1.RX_DV6/CRS_DV6/RX_C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
unnamed: PHY2.RX_CLK/PHYAD2, SW1.RX_CLK6/REFCLKO6
unnamed: PHY2.TX_EN, SW1.TX_EN6/TX_CTL6
unnamed: PHY2.GTX_CLK, SW1.TX_CLK6/REFCLKI6
unnamed: PHY2.ISET, R8.2
RESET: C32.1, D1.A, PHY2.RESET_N, R1.1, SW1.RESET_N
VDDIO: C25.1, C26.1, C27.1, C31.1, D1.C, PHY2.DVDDH@1 (DVDDH), PHY2.DVDDH@2 (DVDDH), PHY2.DVDDH@3 (DVDDH), R1.2, R9.1, R10.1, R11.1, SW1.VDDIO, SW1.VDDIO@1 (VDDIO), SW1.VDDIO@2 (VDDIO)
XI: C33.1, PHY2.XI, Q1.2, SW1.XI
XO: C34.1, Q1.1, SW1.XO

Notes on the sheet:
Main Crystal
Reset
Power Rails
PHY1 MODE(1110) Strap in

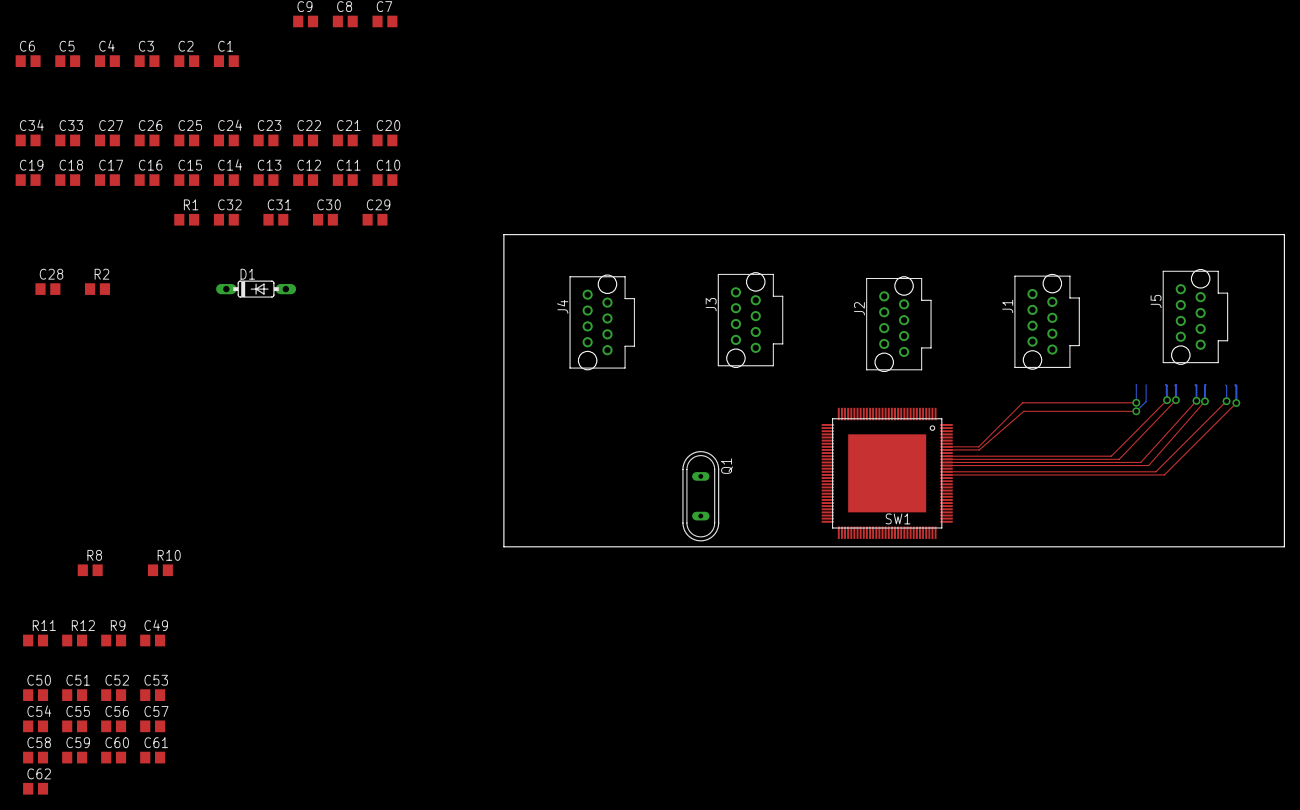
[picture p73: board hardware/pcdu/vhdb_rev1_0/rev1_0.brd from above]

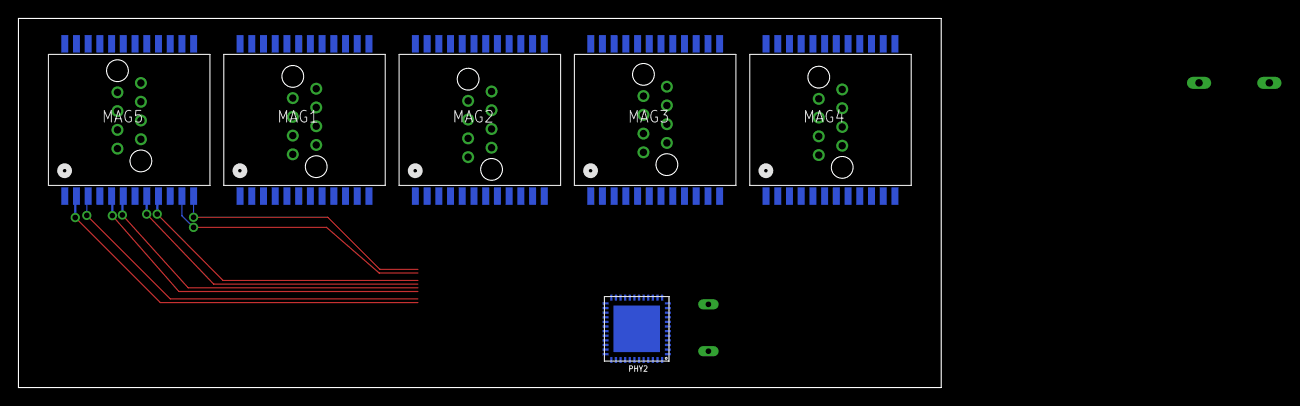
[picture p74: board hardware/pcdu/vhdb_rev1_0/rev1_0.brd from below]

Board: 2 copper layers, 100.0 x 40.0 mm, 69 parts (6 on the bottom side), 102 nets.
