bahusvel/HAPi-Cluster/hardware/pcdu/rev1_6/rev1_6.brd

## EAGLE design hardware/pcdu/rev1_6/rev1_6.brd (2017-01-30)

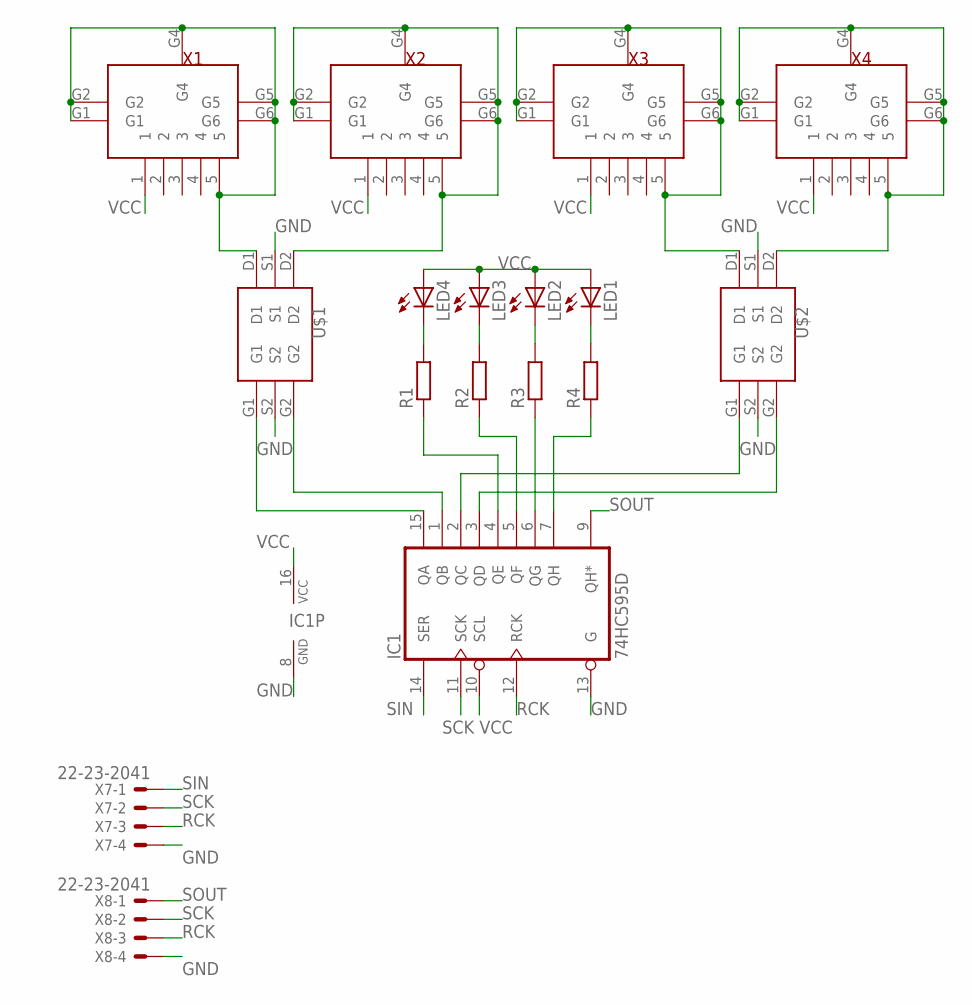
[picture p75: schematic rev1_6.sch]

Parts:
IC1: 74HC595D; SO16
LED1, LED2, LED3, LED4: LED_E; LED_1206
R1, R2, R3, R4: RR1005; R1005
U$1, U$2: FDC6305N; FDC6305
X1, X2, X3, X4: MUSBV
X7, X8: 22-23-2041

Connections:
GND: IC1.8 (GND), IC1.13 (G), U$1.S1, U$1.S2, U$2.S1, U$2.S2, X7.4, X8.4
unnamed: IC1.15 (QA), U$1.G1
unnamed: IC1.1 (QB), U$1.G2
unnamed: IC1.2 (QC), U$2.G1
unnamed: IC1.3 (QD), U$2.G2
unnamed: LED4.C, R1.2
unnamed: LED3.C, R2.2
unnamed: LED2.C, R3.2
unnamed: LED1.C, R4.2
unnamed: U$1.D1, X1.5, X1.G1, X1.G2, X1.G4, X1.G5, X1.G6
unnamed: U$1.D2, X2.5, X2.G1, X2.G2, X2.G4, X2.G5, X2.G6
unnamed: U$2.D1, X3.5, X3.G1, X3.G2, X3.G4, X3.G5, X3.G6
unnamed: U$2.D2, X4.5, X4.G1, X4.G2, X4.G4, X4.G5, X4.G6
unnamed: IC1.4 (QE), R1.1
unnamed: IC1.5 (QF), R2.1
unnamed: IC1.6 (QG), R3.1
unnamed: IC1.7 (QH), R4.1
RCK: IC1.12 (RCK), X7.3, X8.3
SCK: IC1.11 (SCK), X7.2, X8.2
SIN: IC1.14 (SER), X7.1
SOUT: IC1.9 (QH*), X8.1
VCC: IC1.10 (SCL), IC1.16 (VCC), LED1.A, LED2.A, LED3.A, LED4.A, X1.1, X2.1, X3.1, X4.1

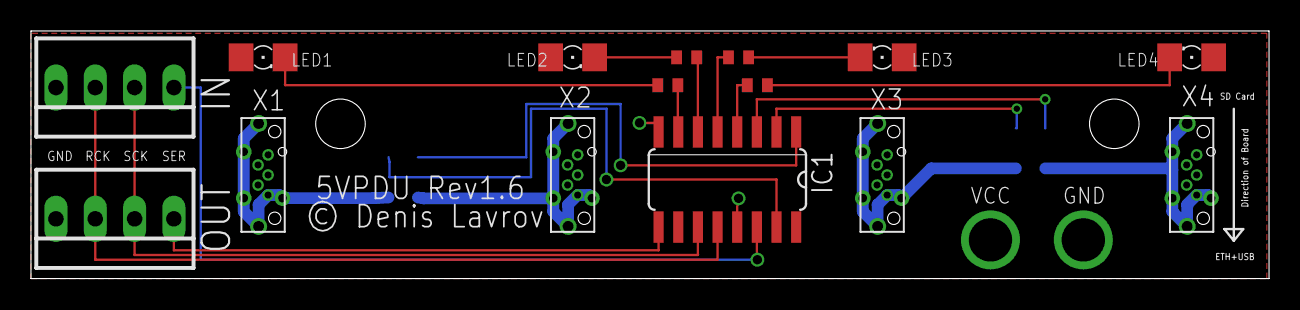
[picture p76: board rev1_6.brd from above]

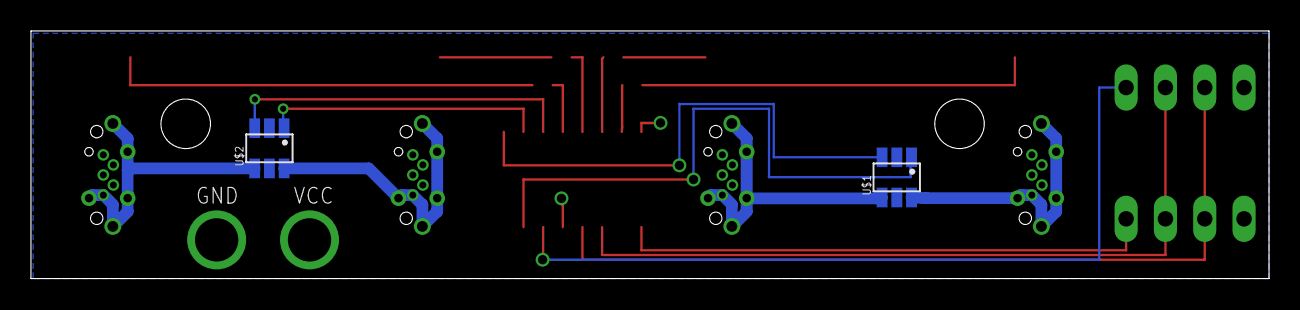
[picture p77: board rev1_6.brd from below]

Board: 2 copper layers, 80.0 x 16.0 mm, 17 parts (2 on the bottom side), 22 nets.
