bahusvel/HAPi-Cluster/hardware/pcdu/pcu_rev1/pcu.brd

## EAGLE design hardware/pcdu/pcu_rev1/pcu.brd (2017-01-21)

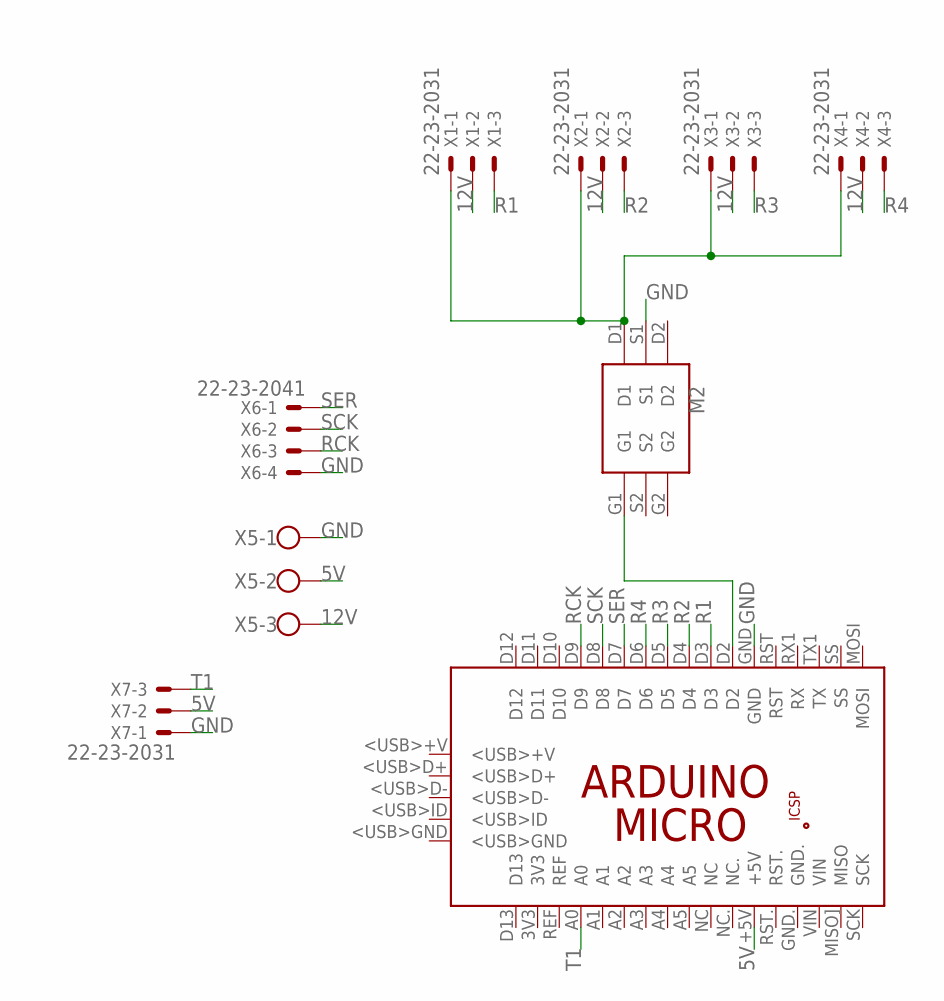
[picture p78: schematic pcu.sch]

Parts:
M2: FDC6305N; FDC6305
PCB1: ARDUINO_MICRO
X1, X2, X3, X4, X7: 22-23-2031
X5: W237-103
X6: 22-23-2041

Connections:
5V: PCB1.+5V, X5.2, X7.2
12V: X1.2, X2.2, X3.2, X4.2, X5.3
GND: M2.S1, PCB1.GND, X5.1, X6.4, X7.1
unnamed: M2.D1, X1.1, X2.1, X3.1, X4.1
unnamed: M2.G1, PCB1.D2
R1: PCB1.D3, X1.3
R2: PCB1.D4, X2.3
R3: PCB1.D5, X3.3
R4: PCB1.D6, X4.3
RCK: PCB1.D9, X6.3
SCK: PCB1.D8, X6.2
SER: PCB1.D7, X6.1
T1: PCB1.A0, X7.3

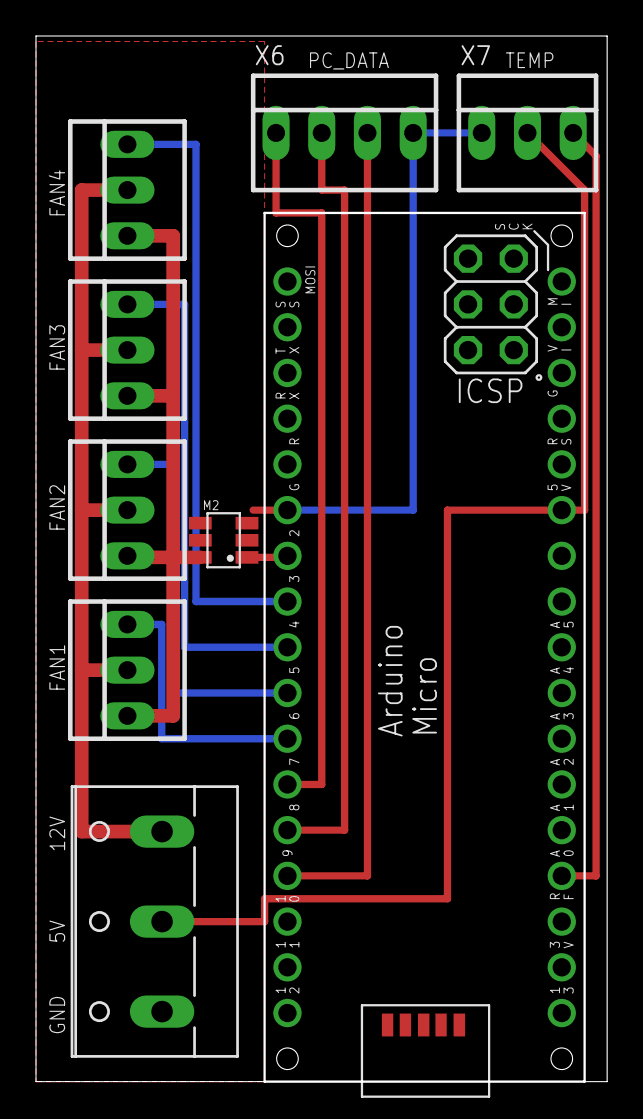
[picture p79: board pcu.brd from above]

Board: 2 copper layers, 31.7 x 58.1 mm, 9 parts (0 on the bottom side), 13 nets.
