bahusvel/HAPi-Cluster/(commit log)

2016-12-01 Added node status printing
2016-12-18 Added pcu code, and chassis controller
2017-01-16 Moved software, added FDC6305N Libary, added rev 1
    [19inch Rack 16U.SLDASM, 19inch Rack 16U.stp, 19inch Rack Corner Section x 16U.sldprt, 19inch Rack In Fill section Front-Rear.sldprt, 19inch Rack In Fill section Side.sldprt, 19inch Rack Top.sldprt, 3u_handle_3D.SLDPRT, In Rack.SLDASM]
2017-01-16 Removed incorrect files, added renders
    [Screen Back.SLDPRT, Screen Back.STL, sunon_blade_80.sldprt, sunon_frame.sldprt]
2017-01-17 Merged ClusterPipe with HAPi-Cluster
    [19inch Rack 16U.SLDASM, 19inch Rack 16U.stp, 19inch Rack Corner Section x 16U.sldprt, 19inch Rack In Fill section Front-Rear.sldprt, 19inch Rack In Fill section Side.sldprt, 19inch Rack Top.sldprt, 3u_handle_3D.SLDPRT, In Rack.SLDASM]
2017-01-17 Uploaded Stage1 BOM
    [Stage1.csv]
2017-01-17 Added Stage2 purchase list
    [Stage2.xlsx]
2017-01-18 Started work on rev1_4 board
    [rev_1_4.brd, rev_1_4.sch]
2017-01-18 Removed eagle trash
    [mainboard.GBL, mainboard.GBO, mainboard.GBP, mainboard.GBS, mainboard.GTL, mainboard.GTO, mainboard.GTP, mainboard.GTS]
2017-01-18 Local power distribution board design
    [RPI SubUnit Full.SLDASM, RPI Unit.SLDASM, rev1_5.brd, rev1_5.sch, rpi_rib_3D.sldprt]
2017-01-21 Added PCU board, updated revision 5 PDU board
    [pcu.brd, pcu.sch, rev1_5.brd, rev1_5.sch]
2017-01-21 Added dru file for the board house of choice
2017-01-22 Updated parts list
    [Stage2.xlsx]
2017-01-23 Added software controlled LED indicators to rev1_5
    [rev1_5.brd, rev1_5.sch]
2017-01-25 Added a unit lid, updated to solidworks 2017
    [3u_handle_3D.SLDPRT, RPI SubUnit Full.SLDASM, RPI Unit.SLDASM, back_panel_6mm.SLDPRT, bottom_plate_6mm.SLDPRT, face_plate_6mm.SLDPRT, lid_hinge_3d.SLDPRT, lid_subasm.SLDASM]
2017-01-28 Updated PDU board, removed screw terminal
    [rev1_6.brd, rev1_6.sch]
2017-01-29 Shrunk width down in preparation for rails
    [RPI Unit.SLDASM, back_panel_6mm.SLDPRT, bottom_plate_6mm.SLDPRT, face_plate_6mm.SLDPRT, lid_subasm.SLDASM, power_lid_6mm.sldprt, power_separator_6mm.SLDPRT, rib_6mm.SLDPRT]
2017-01-29 Fixed power lid, added preliminary rails
    [RPI Unit.SLDASM, back_panel_6mm.SLDPRT, bottom_plate_6mm.SLDPRT, lid_subasm.SLDASM, lower_rail_4mm.SLDPRT, power_lid_6mm.sldprt, power_separator_6mm.SLDPRT, rib_6mm.SLDPRT]
2017-01-30 Added interference hole based unit mounting
    [RPI Unit.SLDASM, face_plate_6mm.SLDPRT, rib_6mm.SLDPRT, side_plate_6mm.SLDPRT]
2017-01-30 Added new mounting desing for RPi
    [RPI SubUnit Full.SLDASM, RPI Unit.SLDASM, pdu_board.SLDPRT, pdu_subasm.SLDASM, rev1_6.brd, rpi_holder_3d.SLDPRT, rpi_rib_3D.sldprt, sunon_fan_red.SLDASM]
2017-02-01 Moved the power separator further back
    [RPI Unit.SLDASM, face_plate_6mm.SLDPRT, lid_subasm.SLDASM, pdu_subasm.SLDASM, power_lid_6mm.sldprt, power_separator_6mm.SLDPRT, rib_6mm.SLDPRT, side_plate_6mm.SLDPRT]
2017-02-01 Migrating some parts to 4mm
    [RPI Unit.SLDASM, back_panel_6mm.SLDPRT, bottom_plate_6mm.SLDPRT, face_plate_6mm.SLDPRT, lid_subasm.SLDASM, lower_rail_4mm.SLDPRT, power_lid_6mm.sldprt, power_separator_6mm.SLDPRT]
2017-02-01 Switched relevant parts to 4mm thickness
    [RPI Unit.SLDASM, back_panel_6mm.SLDPRT, bottom_plate_6mm.SLDPRT, face_plate_6mm.SLDPRT, power_lid_6mm.sldprt, power_separator_6mm.SLDPRT, rib_6mm.SLDPRT, side_plate_6mm.SLDPRT]
2017-02-02 Added some components to stage 2 list
    [Stage2.xlsx]
2017-02-03 Added corner braces, starter work on rails
    [19inch Rack 16U.SLDASM, 19inch Rack Corner Section x 16U.sldprt, 19inch Rack In Fill section Front-Rear.sldprt, 19inch Rack In Fill section Side.sldprt, 19inch Rack Top.sldprt, 2corner_brace_3d.SLDPRT, 3corner_brace_3d.SLDPRT, In Rack.SLDASM]
2017-02-04 Finished simplified rail design
    [In Rack.SLDASM, main_rail_4mm.SLDPRT, mid_plate_6mm.SLDPRT, rail_subasm.SLDASM, rail_support_6mm.SLDPRT, railwidth_6mm.sldprt, sliding_rail_6mm.SLDPRT]
2017-02-06 Added STL files for CubePro Trials
    [3corner_brace_3d.STL, 3u_handle_3D.STL, cat5e_holder_12_3d.STL, cat5e_holder_4_3d.STL, cat5e_holder_8_3d.STL, rpi_holder_3d.STL]
2017-02-06 Added preliminary drawings for laser cutting
    [batch1_6mm.SLDDRW, batch2_6mm.SLDDRW, batch3_4mm.SLDDRW, upper_rail_4mm.SLDPRT]
2017-02-08 Updated 4mm parts to 4.5mm
    [RPI Unit.SLDASM, back_panel_6mm.SLDPRT, bottom_plate_6mm.SLDPRT, face_plate_6mm.SLDPRT, lid_hinge_3d.SLDPRT, lid_subasm.SLDASM, lower_rail_4mm.SLDPRT, main_rail_4mm.SLDPRT]
2017-02-08 Fixed weak sidewall to bottom connection
    [In Rack.SLDASM, RPI Unit.SLDASM, back_panel_6mm.SLDPRT, bottom_plate_6mm.SLDPRT, face_plate_6mm.SLDPRT, lower_rail_4mm.SLDPRT, power_lid_6mm.sldprt, power_separator_6mm.SLDPRT]
2017-02-09 Rail work + corner holes
    [In Rack.SLDASM, RPI Unit.SLDASM, back_panel_6mm.SLDPRT, bottom_plate_6mm.SLDPRT, face_plate_6mm.SLDPRT, lower_rail_4mm.SLDPRT, rail_subasm.SLDASM, railwidth_6mm.sldprt]
2017-02-09 Strengthening round
    [In Rack.SLDASM, RPI Unit.SLDASM, back_panel_6mm.SLDPRT, bottom_plate_6mm.SLDPRT, face_plate_6mm.SLDPRT, lower_rail_4mm.SLDPRT, power_lid_6mm.sldprt, side_plate_6mm.SLDPRT]
2017-02-09 More strenghtening
    [In Rack.SLDASM, RPI Unit.SLDASM, back_panel_6mm.SLDPRT, bottom_plate_6mm.SLDPRT, face_plate_6mm.SLDPRT, lower_rail_4mm.SLDPRT, power supply.SLDPRT, power_lid_6mm.sldprt]
2017-02-09 Experiencing solidworks corruption
    [In Rack.SLDASM, RPI Unit.SLDASM, lower_rail_4mm.SLDPRT, main_rail_4mm.SLDPRT, rail_subasm.SLDASM, rail_support_6mm.SLDPRT, railwidth_6mm.sldprt, sliding_rail_6mm.SLDPRT]
2017-02-10 Added rail latch
    [In Rack.SLDASM, RPI Unit.SLDASM, back_panel_6mm.SLDPRT, bottom_plate_6mm.SLDPRT, face_plate_6mm.SLDPRT, lower_rail_4mm.SLDPRT, main_rail_4mm.SLDPRT, power_separator_6mm.SLDPRT]
2017-02-10 Added endstop, fixed wrong rib height
    [In Rack.SLDASM, RPI Unit.SLDASM, face_plate_6mm.SLDPRT, power_separator_6mm.SLDPRT, rail_endstop_3d.SLDPRT, rail_subasm.SLDASM, rib_6mm.SLDPRT, side_plate_6mm.SLDPRT]
2017-02-11 Added back grill, fixed handles
    [3u_handle_3D.SLDPRT, In Rack.SLDASM, RPI Unit.SLDASM, back_panel_6mm.SLDPRT, bottom_plate_6mm.SLDPRT, lower_rail_4mm.SLDPRT, main_rail_4mm.SLDPRT, power supply.SLDPRT]
2017-02-11 Extended unit to 550, updated the laser cut batches
    [In Rack.SLDASM, RPI Unit.SLDASM, back_panel_6mm.SLDPRT, batch1_6mm.SLDDRW, batch2_6mm.SLDDRW, batch3_4mm.SLDDRW, bottom_plate_6mm.SLDPRT, face_plate_6mm.SLDPRT]
2017-02-11 Started work on eagle library for switch
2017-02-11 Finished switch IC library, started work on vhdb
    [rev1_0.sch]
2017-02-17 Restructured Switch IC symbol, added male rj45 connector library
    [rev1_0.sch]
2017-02-18 Added PHY to vhdb uplink
    [rev1_0.brd, rev1_0.sch]
2017-02-19 Added lan transformers
    [rev1_0.brd, rev1_0.sch]
2017-02-19 Minor changes to high density board
    [rev1_0.brd, rev1_0.sch]
2017-03-06 Added first iteration pdf laser cut files
2017-03-06 Simplified the fan grill
    [RPI Unit.SLDASM, back_panel_6mm.SLDPRT, batch1_6mm.SLDDRW, bottom_plate_6mm.SLDPRT, face_plate_6mm.SLDPRT, power_separator_6mm.SLDPRT]
2017-03-10 Added the ether breakout board
    [mainboard.brd, mainboard.sch, rev1_0.brd, rev1_0.sch, rev1_5.brd, rev1_5.sch, rev_1_3.brd, rev_1_3.sch]
