bahusvel/HAPi-Cluster/(notices)

Notices in the files:
hardware/pcdu/rev1_6/rev1_6.brd:
© Denis Lavrov
